BaQs/dragon-radar/hardware/dragon-radar-1.43/dragon-radar-1.43.3mf

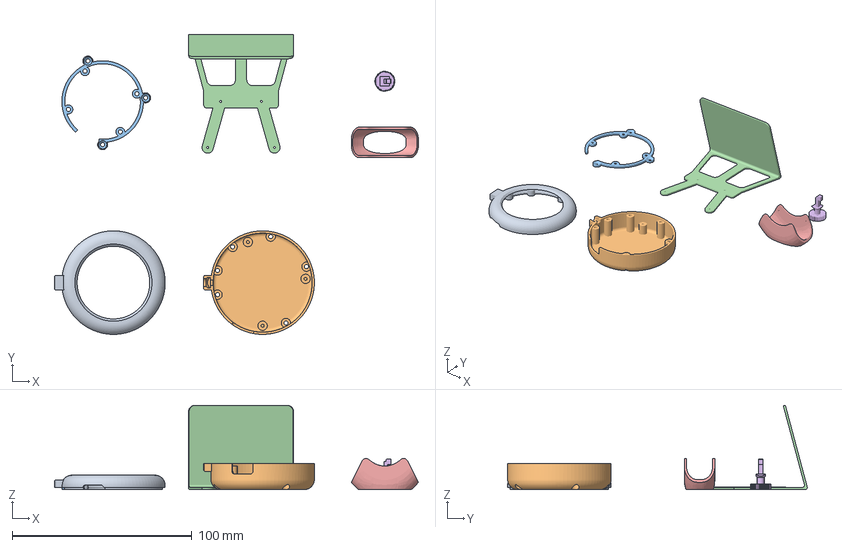
[picture p3: CAD file, 2026-11-02]
hardware/dragon-radar-1.43/dragon-radar-1.43.3mf
202.5 x 166.8 x 46.9 mm
Face (lèvre en haut)
Dos
Berceau de la carte
Support - pied
Support - berceau
Molette (roue en bas)
