BaQs/dragon-radar/hardware/dragon-radar-1.43/step/dos.step

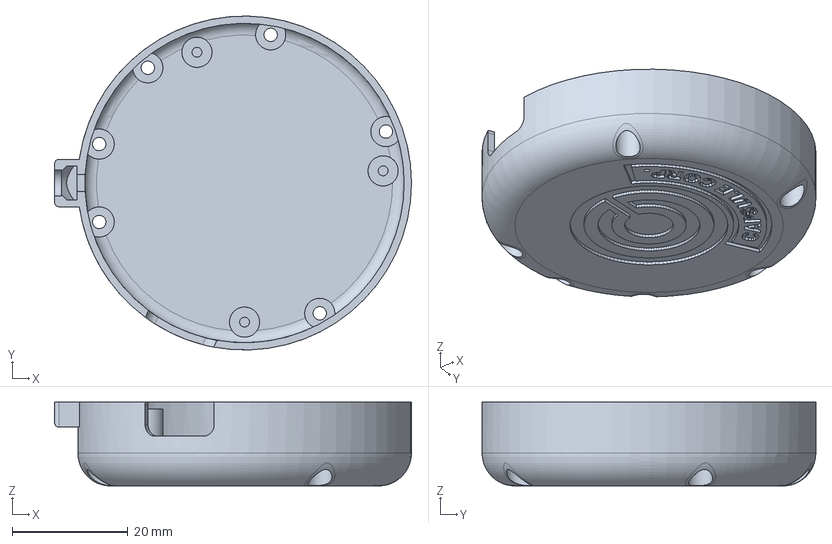
[picture p4: CAD file, 2026-11-02]
hardware/dragon-radar-1.43/step/dos.step
61.6 x 57.6 x 14.5 mm
