BaQs/dragon-radar/hardware/dragon-radar-1.43/step/support_pied.step

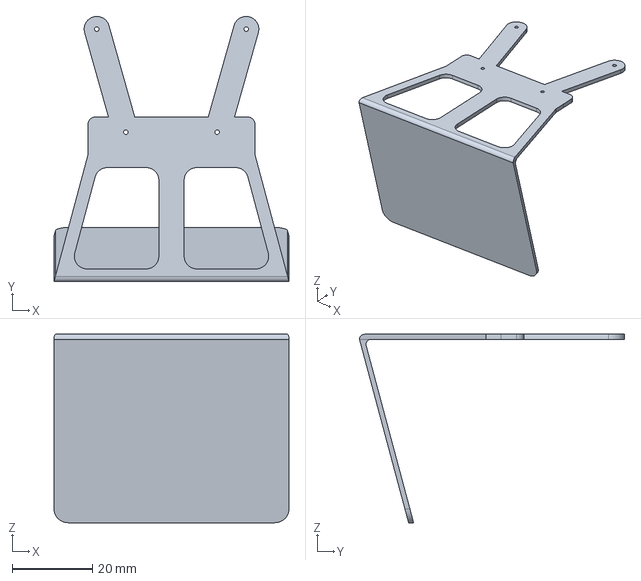
[picture p5: CAD file, 2026-11-02]
hardware/dragon-radar-1.43/step/support_pied.step
58.5 x 66.0 x 46.9 mm
