BaQs/dragon-radar/hardware/dragon-radar-1.43/step/support_berceau.step

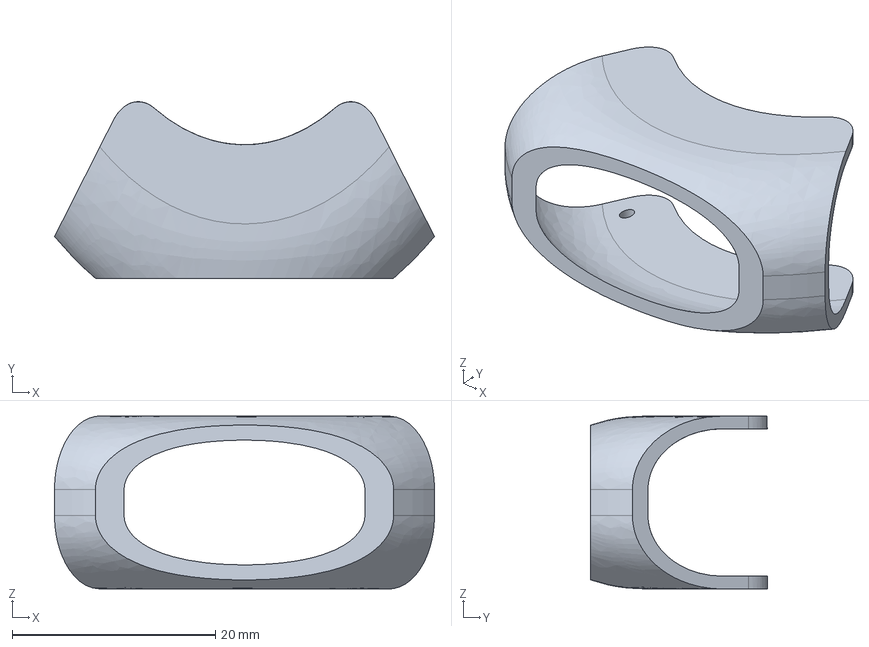
[picture p6: CAD file, 2026-11-02]
hardware/dragon-radar-1.43/step/support_berceau.step
37.4 x 17.4 x 17.0 mm
