BaQs/dragon-radar/hardware/dragon-radar-1.43/step/molette.step

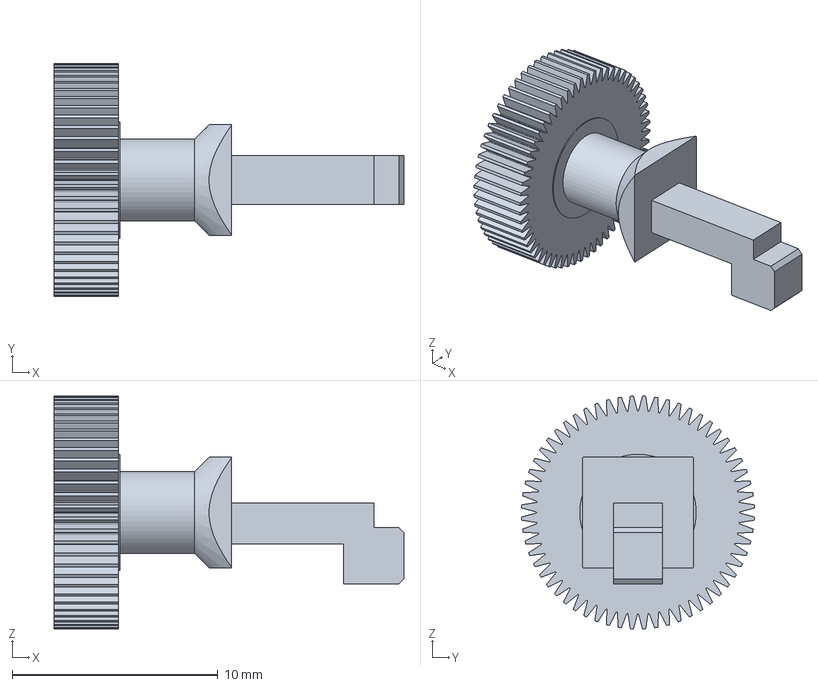
[picture p7: CAD file, 2026-11-02]
hardware/dragon-radar-1.43/step/molette.step
17.0 x 11.3 x 11.3 mm
