BaQs/dragon-radar/hardware/dragon-radar-1.43/step/face.step

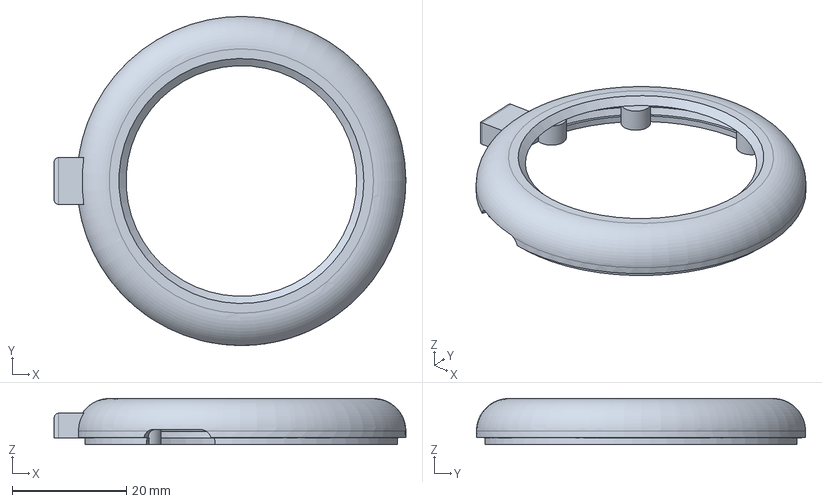
[picture p8: CAD file, 2026-11-02]
hardware/dragon-radar-1.43/step/face.step
61.6 x 57.6 x 8.06 mm
