BaQs/dragon-radar/hardware/dragon-radar-1.43/step/berceau.step

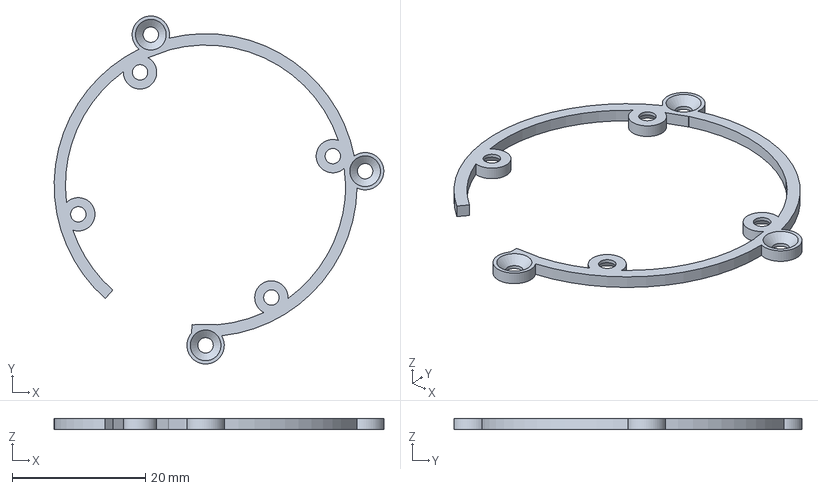
[picture p9: CAD file, 2026-11-02]
hardware/dragon-radar-1.43/step/berceau.step
49.4 x 52.1 x 1.60 mm
