BaQs/dragon-radar/hardware/dragon-radar-1.43/step/logo.step

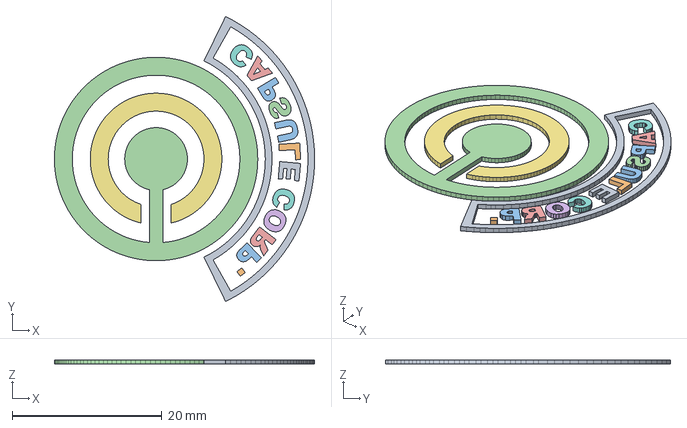
[picture p10: CAD file, 2026-11-02]
hardware/dragon-radar-1.43/step/logo.step
34.8 x 38.1 x 0.6 mm
