BaQs/dragon-radar/(list of files, cad)

Other CAD files:
hardware/dragon-radar-1.43/stl/berceau.stl
hardware/dragon-radar-1.43/stl/dos.stl
hardware/dragon-radar-1.43/stl/face.stl
hardware/dragon-radar-1.43/stl/logo.stl
hardware/dragon-radar-1.43/stl/molette.stl
hardware/dragon-radar-1.43/stl/support_berceau.stl
hardware/dragon-radar-1.43/stl/support_pied.stl
