BaQs/dragon-radar/src/main.cpp

// Capsule Radar — entry point / glue.
#include <Arduino.h>
#include <WiFi.h>
#include <vector>
#include "config.h"
#include "web_input.h"              // strict parsing of numbers from the config page
#include "aircraft.h"
#include "geo.h"
#include "adsb_client.h"
#include "snapshot_gate.h"
#include "feed_watchdog.h"
#include "route.h"
#include "route_client.h"
#include "photo.h"
#include "photo_client.h"
#include "weather.h"
#include "weather_client.h"
#include "wx_radar.h"
#include "wx_radar_client.h"
#include "cloud_image.h"
#include "cloud_image_client.h"
#include "radar_view.h"
#include "ui.h"
#include "display.h"                  // M0: CO5300 + LVGL bring-up
#include "imu_qmi8658.h"             // face-down sleep: accelerometer reads
#include "facedown_sleep.h"          // face-down sleep: the decision
#include "boot_button.h"             // BOOT button: zoom / deep sleep
#include <esp_sleep.h>
#include <driver/rtc_io.h>
#include "gps.h"                     // LC76G GNSS (-G variant only)
#include "battery.h"                 // AXP2101 battery gauge
#include "rtc_pcf85063.h"            // PCF85063 RTC (offline clock + date)
#include "audio.h"                   // ES8311 alert pings
#include <set>                       // audio: track which contacts are in range
#include <string>
#include <WiFiManager.h>             // captive portal
#include <Preferences.h>            // NVS (persist theme/settings)
#include <time.h>                   // NTP/RTC clock + date
#include <esp_sntp.h>               // SNTP sync callback: a REAL NTP fix (not just a plausible epoch)
#include <WebServer.h>              // configuration web page
#include <ESPmDNS.h>                // http://capsuleradar.local
#include <ArduinoOTA.h>             // OTA firmware update over WiFi (PlatformIO/espota)
#include <Update.h>                 // browser OTA: self-flash an uploaded .bin
#include <esp_heap_caps.h>          // largest-free-block metric (heap health)
#include <esp_wifi.h>               // WiFi driver control (reset must survive the reboot)
#include <nvs.h>                    // erase the driver's "nvs.net80211" namespace (WiFi reset)
#include <mbedtls/platform.h>       // route mbedTLS allocations to PSRAM

// mbedTLS allocates from internal RAM by default (the prebuilt core has
// CONFIG_MBEDTLS_INTERNAL_MEM_ALLOC). Its ~16 KB record buffers, allocated and freed on
// every HTTPS fetch, fragment the internal heap until a handshake can't find a
// contiguous block (-32512) and the feed freezes. Put them in PSRAM instead, the same
// as ESP-IDF's CONFIG_MBEDTLS_EXTERNAL_MEM_ALLOC; fall back to internal RAM if needed.
static void *tls_calloc(size_t n, size_t size) {
    return heap_caps_calloc_prefer(n, size, 2, MALLOC_CAP_SPIRAM | MALLOC_CAP_8BIT,
                                   MALLOC_CAP_INTERNAL | MALLOC_CAP_8BIT);
}
static void tls_free(void *p) { heap_caps_free(p); }

// ---- shared state ----
static std::vector<Aircraft> g_aircraft;      // latest snapshot
static SemaphoreHandle_t     g_ac_mutex;      // guards g_aircraft
static volatile bool         g_acDirty = false; // set when a new snapshot is ready
static AdsbClient            g_adsb;
static RadarSettings         g_settings;
static WiFiManager           g_wm;
static int                   g_brightnessDay = BRIGHTNESS_DEFAULT;   // user brightness (web/NVS)
static int                   g_volume = 60;                          // alert volume 0..100 (web/NVS)
static bool                  g_muted  = false;                       // mute alert pings
static int                   g_alertMode = 2;                        // 0=off 1=emergencies 2=new+emergencies (web/NVS)
static float                 g_proximityKm = 0.0f;                   // proximity alert radius, km (0=off) (web/NVS)
static uint32_t              g_idleDimMs = IDLE_DIM_MS;              // dim after this idle time (0 = never)
static bool                  g_fdSleep = true;                       // face-down sleep (screen off) on/off (web/NVS)
static bool                  g_clockOn = true;                       // idle clock instead of the idle dim (web/NVS)
static bool                  g_showSweep = true;                     // rotating sweep line on/off (web/NVS)
static int                   g_units = 0;                            // 0=Aviation 1=Metric 2=Imperial (web/NVS)
static bool                  g_showAirports = true;                  // airport markers on/off (web/NVS)
static bool                  g_hideGround   = false;                 // skip on-ground aircraft in the feed (web/NVS)
static int                   g_minAltFt     = 0;                     // only show aircraft above this altitude, ft (0 = off) (web/NVS)
static int                   g_maxAltFt     = 0;                     // only show aircraft below this altitude, ft (0 = off) (web/NVS)
static int                   g_lastView     = 0;                     // last active view (0 radar/1 list/2 stats/3 weather) (NVS)
static bool                  g_bootedIntoPortal = false;             // saved WiFi absent at boot (e.g. car hotspot not up yet)
static bool                  g_milOnly      = false;                 // only show military-flagged aircraft (web/NVS)
static int                   g_rotation = 0;                         // clockwise display rotation, 0..359° (web/NVS)
static bool                  g_useGps = false;                       // auto-set home from the LC76G GPS (-G variant) (web/NVS)
static int                   g_trailLen = 2;                         // aircraft trails 0=off 1=short 2=med 3=long (web/NVS)
static int                   g_maxAc = 20;                           // max aircraft drawn on the scope (web/NVS)
static bool                  g_bigText = false;                      // accessibility: large fonts (web/NVS, applied at boot)
static volatile bool         g_onBattery = false;                    // discharging (set on core 1, read on core 0)
static volatile bool         g_rtcSyncPending = false;               // SNTP synced: RTC should be rewritten on core 1
static std::vector<Aircraft> g_snap;                                 // last snapshot (instant re-render on zoom)
static volatile bool         g_requery = false;                      // range changed -> adsb_task re-begins
static float                 g_requeryKm = 0.0f;
static volatile bool         g_feedOk = true;                        // ADS-B feed healthy? (HUD warning)
static volatile uint32_t     g_lastFeedOkMs = 0;                     // millis() of the last good poll (HUD staleness)
static volatile uint32_t     g_powerOffAtMs = 0;                     // !=0: AXP2101 power-off when millis() reaches it
static volatile uint32_t     g_rebootAtMs = 0;                       // !=0: reboot when millis() reaches it (clean start after WiFi config)
static bool                  g_pmicOk = false;                       // AXP2101 answered (powers the power-off paths)
static bool                  g_updateBlocked = false;                // /update: refused at START (cross-site), 403 sent on completion
static bool                  g_updateDone = false;                   // /update: Update.end() succeeded -> the completion handler may reboot
static String                g_tz = TZ_STR;                          // POSIX timezone (web-configurable, NVS); applied via configTzTime
static volatile bool         g_weatherDirty = false;
static volatile bool         g_wxRadarDirty = false;
static volatile bool         g_cloudImageDirty = false;

// Web-selectable time zones (label + POSIX TZ). The <option> value is the index; the save
// handler maps it back to the POSIX string stored in NVS and used by configTzTime at boot.
// (Index avoids putting POSIX strings with '<>' / ',' into HTML attributes.)
// offMin = standard (winter) UTC offset in minutes; dst = 1 if the zone observes DST.
// The web page uses these to auto-pick the visitor's zone from their browser clock.
static const struct { const char *label; const char *tz; int offMin; int dst; } TZOPTS[] = {
    {"UTC",                      "UTC0",                              0, 0},
    {"London / Lisbon",          "GMT0BST,M3.5.0/1,M10.5.0",          0, 1},
    {"Madrid / Paris / Berlin",  "CET-1CEST,M3.5.0,M10.5.0/3",       60, 1},
    {"Athens / Helsinki",        "EET-2EEST,M3.5.0/3,M10.5.0/4",     120, 1},
    {"Istanbul / Moscow",        "<+03>-3",                          180, 0},
    {"New York (US Eastern)",    "EST5EDT,M3.2.0,M11.1.0",          -300, 1},
    {"Chicago (US Central)",     "CST6CDT,M3.2.0,M11.1.0",          -360, 1},
    {"Denver (US Mountain)",     "MST7MDT,M3.2.0,M11.1.0",          -420, 1},
    {"Phoenix (Arizona)",        "MST7",                            -420, 0},
    {"Los Angeles (US Pacific)", "PST8PDT,M3.2.0,M11.1.0",          -480, 1},
    {"Anchorage (Alaska)",       "AKST9AKDT,M3.2.0,M11.1.0",        -540, 1},
    {"Honolulu (Hawaii)",        "HST10",                           -600, 0},
    {"Argentina / Brazil (E)",   "<-03>3",                          -180, 0},
    {"India (IST)",              "<+0530>-5:30",                     330, 0},
    {"China / Singapore",        "<+08>-8",                          480, 0},
    {"Japan / Korea",            "JST-9",                            540, 0},
    {"Sydney (AU Eastern)",      "AEST-10AEDT,M10.1.0,M4.1.0/3",     600, 1},
    {"Auckland (NZ)",            "NZST-12NZDT,M9.5.0,M4.1.0/3",      720, 1},
};
static const int TZOPTS_N = sizeof(TZOPTS) / sizeof(TZOPTS[0]);

// ---- networking task (core 0): fetch + parse, never touches the display ----
static void adsb_task(void*) {
    std::vector<Aircraft> fresh;
    AircraftSnapshotGate snapshotGate;
    bool retainingEmptySnapshot = false;
    bool wasConnected = false;
    uint32_t lastPoll = 0;
    uint32_t nextWeatherAt = UINT32_MAX;       // armed five seconds after WiFi connects
    uint32_t nextWxRadarAt = UINT32_MAX;
    uint32_t nextCloudImageAt = UINT32_MAX;
    FeedWatchdog watchdog(millis());         // self-heal: see feed_watchdog.h
    for (;;) {
        const bool conn = (WiFi.status() == WL_CONNECTED);
        if (conn && !wasConnected) {
            // disable WiFi modem power-save: on a mains-powered desk gadget it just adds latency
            // and makes RSSI bounce (feed goes stale -> amber bars) even sitting next to the router.
            WiFi.setSleep(false);
            Serial.printf("[adsb] WiFi up, IP %s\n", WiFi.localIP().toString().c_str());
            configTzTime(g_tz.c_str(), "pool.ntp.org", "time.nist.gov");  // local time (web-configurable TZ)
            Serial.println("[web] config: http://capsuleradar.local/  (or the IP above)");
            nextWeatherAt = millis() + 5000UL; // let the first ADS-B poll complete before weather TLS
            nextCloudImageAt = millis() + 15000UL;
            nextWxRadarAt = millis() + 12000UL;
            // mDNS + OTA are started on core 1 (loop) to keep all mDNS use on one core
        }
        wasConnected = conn;
        // Self-heal: reboot at once for a fragmented internal heap starving TLS, and as a
        // last resort after ADSB_STUCK_HARD_MS whatever the heap says. Not for refusals or
        // a short internet outage behind working WiFi (see feed_watchdog.h).
        if (const uint32_t answeredMs = g_adsb.lastResponseMs()) watchdog.onAnswer(answeredMs);
        switch (watchdog.check(conn, millis(), g_adsb.allParked(), [] {
                    return (uint32_t)heap_caps_get_largest_free_block(MALLOC_CAP_INTERNAL); })) {
            case FeedWatchdog::RESTART:
                Serial.printf("[adsb] feed stuck >%us and internal heap fragmented -> restarting to recover\n",
                              (unsigned)(ADSB_STUCK_MS / 1000));
                delay(100);
                ESP.restart();
                break;
            case FeedWatchdog::RESTART_LONG:
                Serial.printf("[adsb] feed stuck >%u min with WiFi up -> restarting as a last resort\n",
                              (unsigned)(ADSB_STUCK_HARD_MS / 60000UL));
                delay(100);
                ESP.restart();
                break;
            case FeedWatchdog::LOG_STUCK:
                Serial.printf("[adsb] feed stuck >%us with WiFi up (no internet?); heap OK, staying up\n",
                              (unsigned)(ADSB_STUCK_MS / 1000));
                break;
            case FeedWatchdog::NONE:
                break;
        }
        if (g_requery) {                          // display range changed (double-tap zoom)
            g_adsb.begin(g_settings.homeLat, g_settings.homeLon, g_requeryKm);
            g_requery = false;
            lastPoll = 0;                         // poll immediately at the new radius
        }
        if (conn) {
            // The live aircraft feed is the primary job, so poll FIRST every cycle. That keeps
            // it refreshing even while the user taps around — a slow route/photo lookup (below)
            // can block this single network task, so it must never get ahead of the feed.
            const uint32_t nowMs = millis();
            const uint32_t pollInterval = g_onBattery ? POLL_INTERVAL_BATTERY_MS : POLL_INTERVAL_MS;
            if (lastPoll == 0 || nowMs - lastPoll >= pollInterval) {  // aircraft feed
                lastPoll = nowMs;
                static int failCount = 0;
                // poll() tries the fallback provider after a primary failure; keep the HUD
                // healthy through isolated misses and warn only after a sustained outage.
                if (g_adsb.poll(fresh)) {
                    Serial.printf("[adsb] fetched %u aircraft from %s\n", (unsigned)fresh.size(), g_adsb.lastHost());
                    failCount = 0;
                    g_feedOk = true;
                    const uint32_t receivedMs = millis();
                    watchdog.onPoll(FeedWatchdog::FETCHED, receivedMs);
                    g_lastFeedOkMs = receivedMs;      // HUD: mark data as fresh

                    const bool publish = snapshotGate.shouldPublish(
                        !fresh.empty(), receivedMs, AC_STALE_MS);
                    if (!publish) {
                        if (!retainingEmptySnapshot) {
                            Serial.printf("[adsb] empty snapshot; retaining contacts for %u ms\n",
                                          (unsigned)AC_STALE_MS);
                            retainingEmptySnapshot = true;
                        }
                    } else {
                        if (retainingEmptySnapshot && fresh.empty())
                            Serial.println("[adsb] empty snapshot persisted; clearing stale contacts");
                        retainingEmptySnapshot = false;
                        if (xSemaphoreTake(g_ac_mutex, pdMS_TO_TICKS(200)) == pdTRUE) {
                            g_aircraft.swap(fresh);   // O(1) handoff: no per-Aircraft String copies under the lock
                            g_acDirty = true;
                            xSemaphoreGive(g_ac_mutex);
                        }
                    }
                } else if (g_adsb.lastPollSkipped()) {
                    // Every provider is parked or inside its spacing/silence window: we chose
                    // not to ask. Logging this each tick would bury the real errors, and
                    // counting it would show an outage warning for our own politeness.
                    // Prolonged silence still trips the warning, via the time check rather
                    // than a fail count. Not proof of life for the watchdog: nothing was sent.
                    watchdog.onPoll(FeedWatchdog::SKIPPED, nowMs);
                    if ((int32_t)(nowMs - g_adsb.lastOkMs()) > (int32_t)ADSB_FEED_STALE_MS)
                        g_feedOk = false;
                } else {
                    Serial.println("[adsb] poll failed");
                    watchdog.onPoll(FeedWatchdog::FAILED, nowMs);
                    if (++failCount >= 5) g_feedOk = false;   // sustained outage -> HUD warning
                }
            }
            // Forecasts change slowly. Fetch only after the live ADS-B poll has had priority.
            if ((int32_t)(nowMs - nextWeatherAt) >= 0) {
                Serial.printf("[weather] fetching %.5f, %.5f...\n",
                              g_settings.homeLat, g_settings.homeLon);
                WeatherSnapshot forecast;
                if (weather_fetch(g_settings.homeLat, g_settings.homeLon, forecast)) {
                    weather_store(forecast);
                    g_weatherDirty = true;
                    nextWeatherAt = millis() + WEATHER_REFRESH_MS;
                    Serial.println("[weather] forecast updated");
                } else {
                    nextWeatherAt = millis() + 60000UL;
                    Serial.println("[weather] fetch failed; retrying in 60s");
                }
            }
            if ((int32_t)(nowMs - nextWxRadarAt) >= 0) {
                Serial.println("[wxradar] fetching latest frame...");
                if (wx_radar_fetch(g_settings.homeLat, g_settings.homeLon)) {
                    g_wxRadarDirty = true;
                    nextWxRadarAt = millis() + WX_RADAR_REFRESH_MS;
                } else {
                    nextWxRadarAt = millis() + 60000UL;
                    Serial.println("[wxradar] fetch failed; retrying in 60s");
                }
            }
            if ((int32_t)(nowMs - nextCloudImageAt) >= 0) {
                Serial.println("[clouds] fetching EUMETSAT frame...");
                if (cloud_image_fetch(g_settings.homeLat, g_settings.homeLon)) {
                    g_cloudImageDirty = true;
                    nextCloudImageAt = millis() + CLOUD_IMAGE_REFRESH_MS;
                } else {
                    nextCloudImageAt = millis() + 60000UL;
                    Serial.println("[clouds] fetch failed; retrying in 60s");
                }
            }
            // Then the on-demand lookups for the selected aircraft. Their timeouts are kept
            // short (see photo_client / route_client) so a slow photo server can't freeze the
            // feed for long; the next loop iteration polls again as soon as they return.
            char wantCall[12];
            if (route_pending(wantCall, sizeof(wantCall))) {
                char from[40] = "", to[40] = "";
                if (route_cache_get(wantCall, from, sizeof(from), to, sizeof(to))) {
                    route_store(wantCall, from, to);                       // NVS hit, no network
                    Serial.printf("[route] %s (cache): '%s' -> '%s'\n", wantCall, from, to);
                } else if (route_fetch(wantCall, from, sizeof(from), to, sizeof(to))) {
                    route_store(wantCall, from, to);
                    route_cache_put(wantCall, from, to);                  // remember across reboots
                    Serial.printf("[route] %s (net): '%s' -> '%s'\n", wantCall, from, to);
                } else {
                    route_store(wantCall, from, to);   // empty -> don't refetch this session
                    Serial.printf("[route] %s: no route\n", wantCall);
                }
            }
            char wantHex[10];
            if (photo_pending(wantHex, sizeof(wantHex))) photo_fetch(wantHex);
        }
        vTaskDelay(pdMS_TO_TICKS(250));
    }
}

static void loadSettings() {
    Preferences p;
    p.begin("capsuleradar", true);
    g_settings.homeLat = p.getDouble("homeLat", HOME_LAT_DEFAULT);
    g_settings.homeLon = p.getDouble("homeLon", HOME_LON_DEFAULT);
    // Repair a value that can't work: an old install may hold the 250 km the web page once
    // offered (clamped to 150) or even 0 (divides by zero in geo::projectToScreen).
    g_settings.rangeKm = repairRangeKm(p.getFloat("rangeKm", RANGE_KM_DEFAULT));
    // floor of 5: a stored 0 would boot with the panel dark forever, looking like a dead board
    g_brightnessDay    = constrain(p.getInt("bright", BRIGHTNESS_DEFAULT), 5, 255);
    g_volume           = p.getInt("vol", 60);
    g_muted            = p.getBool("mute", false);
    g_alertMode        = p.getInt("alertmode", 2);
    g_proximityKm      = p.getFloat("proxkm", 0.0f);
    g_useGps           = p.getBool("usegps", false);
    g_trailLen         = p.getInt("traillen", 2);
    g_maxAc            = p.getInt("maxac", 20);
    g_idleDimMs        = p.getUInt("idledim", IDLE_DIM_MS);
    g_fdSleep          = p.getBool("fdsleep", true);
    g_clockOn          = p.getBool("clock", true);
    g_units            = p.getInt("units", 0);
    g_tz               = p.getString("tz", TZ_STR);
    g_bigText          = p.getBool("bigtext", false);
    p.end();
    // fonts are baked into the widgets at creation time, so the large-text flag must be
    // in place before display::begin() builds the UI (loadSettings runs first in setup)
    ui_set_large_text(g_bigText);
    radar::setLargeText(g_bigText);
}

// Audio alerts. g_alertMode: 0 = off, 1 = emergencies only, 2 = new aircraft + emergencies.
// g_proximityKm > 0 also pings (once) when any aircraft crosses into that radius.
static void checkAudioEvents() {
    if (!audio_present()) return;
    static std::set<std::string> seen, seenProx;
    static bool first = true;
    static uint32_t lastNew = 0;
    std::set<std::string> now, nowProx;
    for (const Aircraft &ac : g_snap) {
        const double d = geo::haversineKm(g_settings.homeLat, g_settings.homeLon, ac.lat, ac.lon);
        if (d > g_settings.rangeKm) continue;                 // in-range only
        const std::string hex = ac.hex.c_str();
        now.insert(hex);
        const bool isNew     = !first && !seen.count(hex);
        const bool emergency = acIsEmergency(ac.squawk) || ac.military;  // military: feed dbFlags

        // proximity: fire once, when an aircraft first crosses into the radius (any aircraft)
        if (g_proximityKm > 0.0f && d <= g_proximityKm) {
            nowProx.insert(hex);
            if (!first && !seenProx.count(hex)) audio_play(AUDIO_ALERT);
        }

        // new-in-range pings (on entry), gated by the alert mode
        if (isNew) {
            if (emergency) { if (g_alertMode >= 1) audio_play(AUDIO_ALERT); }   // emergencies only / +new
            else if (g_alertMode >= 2 && millis() - lastNew > 3000) {
                audio_play(AUDIO_NEW);                                          // new contact (rate-limited)
                lastNew = millis();
            }
        }
    }
    seen.swap(now);
    seenProx.swap(nowProx);
    first = false;
}

// Feed query radius: wider than the display range (so off-range traffic shows as edge
// arrows) AND wide enough to cover the proximity-alert circle (else an alert radius larger
// than the query would never fire), clamped to keep busy-airspace downloads bounded.
static float queryRadiusKm() {
    float km = g_settings.rangeKm * ADSB_QUERY_MULT;
    if (g_proximityKm > 0.0f && g_proximityKm * 1.2f > km) km = g_proximityKm * 1.2f;
    return constrain(km, ADSB_QUERY_MIN_KM, ADSB_QUERY_MAX_KM);
}

// Double-tap zoom: change the display range, persist it, and ask adsb_task to
// re-query at a matching radius (safely, on its own core). Re-render immediately.
static void onRangeChange(float km) {
    g_settings.rangeKm = km;
    Preferences p;
    p.begin("capsuleradar", false);
    p.putFloat("rangeKm", km);
    p.end();
    g_requeryKm = queryRadiusKm();
    g_requery = true;
    radar::update(g_snap, g_settings);   // instant visual zoom from the last snapshot
    ui_set_range_km(km);
    ui_on_data_updated();
}

// Persist the visual theme in NVS (called when the user long-presses to switch).
static void saveTheme(int t) {
    Preferences p;
    p.begin("capsuleradar", false);
    p.putInt("theme", t);
    p.end();
}

// Convert a UTC broken-down time to time_t (mktime assumes local TZ, so flip to UTC0).
static time_t utc_to_time(struct tm *utc) {
    setenv("TZ", "UTC0", 1); tzset();
    const time_t t = mktime(utc);
    setenv("TZ", g_tz.c_str(), 1); tzset();   // restore the SAVED zone, not the Spain default
    return t;
}

// Seed the ESP system clock from the RTC so the clock/date are right before NTP.
static void rtc_seed_clock() {
    struct tm utc;
    if (!rtc_read(&utc)) { Serial.println("[rtc] no valid time stored"); return; }
    const time_t t = utc_to_time(&utc);
    struct timeval tv = { t, 0 };
    settimeofday(&tv, nullptr);
    Serial.println("[rtc] system clock seeded from RTC");
}

// Brightness: face-down sleep wins (screen off), then the idle clock, then the idle dim.
// The clock ramps the panel from the day brightness to clockB along with its animation,
// so the loop calls this on every pass; the panel is written only when the value changes.
static bool g_asleep    = false;   // face-down
static bool g_idle      = false;   // no touch for a while
static bool g_clockHold = false;   // idle with the clock on, but an emergency in range keeps the radar up
static void applyBrightness() {
    const int day = g_brightnessDay;
    int b = day;
    // p is 0 on the pass that starts the clock (and a full LVGL repaint follows it), so test
    // clockRequested() too: falling through to the idle dim there would blink the panel.
    const float p = radar::clockProgress();
    if (radar::clockRequested() || p > 0) {
        const int clockB = max(day * CLOCK_BRIGHTNESS_PCT / 100, min(day, BRIGHTNESS_IDLE));
        b = day + (int)lroundf((float)(clockB - day) * p);
    } else if (g_idle && !g_clockHold) {
        b = min(day, BRIGHTNESS_IDLE);                           // idle only dims down
    }
    if (g_asleep) b = 0;                                         // face-down -> screen off
    static int shown = -1;
    if (b != shown) { shown = b; display::setBrightness((uint8_t)b); }
}

// ----------------------------- configuration web --------------------------------
static WebServer g_web(80);

// ---- cross-site request guard (CSRF) ----
// A hostile web page can make the VICTIM's browser send requests to this device, which
// sits on the same LAN. It cannot read any answer (we send no CORS headers), so refusing
// the request defeats it. Two layers:
//  - requestCrossSite() refuses what the browser itself marks as cross-site. Over plain
//    http:// browsers send NO Sec-Fetch-Site (Fetch Metadata only goes to HTTPS and
//    localhost), but every cross-site POST carries Origin. That guards the POSTs (/save,
//    /wifi, /poweroff, /update): plain HTML forms send those, so they cannot carry a
//    custom header. Same-origin requests and header-less clients (curl, the IDE's
//    uploader) pass.
//  - refuseUnlessPageFetch() guards the live-setting GETs (/bright, /vol, ...) as well. A
//    cross-site <img src="http://capsuleradar.local/bright?v=5"> sends neither
//    Sec-Fetch-Site nor Origin, so these also demand the WEB_PAGE_HDR header. Only a script
//    can add a custom header, and a cross-origin fetch() with one needs a CORS preflight
//    this server never approves; <img>, links and forms cannot send it at all. The config
//    page's own fetch() calls (G() in its script) send it; curl needs -H 'X-Radar: 1'.
#define WEB_PAGE_HDR "X-Radar"
static bool requestCrossSite() {
    const String sfs = g_web.header("Sec-Fetch-Site");
    if (sfs.length() && sfs != "same-origin" && sfs != "none") return true;
    const String origin = g_web.header("Origin");
    if (origin.length()) {
        // "http://192.168.4.1" / "https://capsuleradar.local": compare the authority
        // with the Host header, ignoring default ports on either side.
        const int scheme = origin.indexOf("://");
        String auth = (scheme < 0) ? origin : origin.substring(scheme + 3);
        const int slash = auth.indexOf('/');
        if (slash >= 0) auth = auth.substring(0, slash);
        String host = g_web.hostHeader();
        if (auth.endsWith(":80"))  auth = auth.substring(0, auth.length() - 3);
        if (auth.endsWith(":443")) auth = auth.substring(0, auth.length() - 4);
        if (host.endsWith(":80"))  host = host.substring(0, host.length() - 3);
        if (host.endsWith(":443")) host = host.substring(0, host.length() - 4);
        if (!auth.equalsIgnoreCase(host)) return true;
    }
    return false;
}

// First line of every state-changing POST handler: rejects (and answers 403) or passes.
static bool refuseIfCrossSite() {
    if (!requestCrossSite()) return false;
    g_web.send(403, "text/plain", "cross-site request rejected");
    return true;
}

// First line of every live-setting GET handler (see the guard notes above).
static bool refuseUnlessPageFetch() {
    if (g_web.header(WEB_PAGE_HDR) != "1") {
        g_web.send(403, "text/plain", "missing " WEB_PAGE_HDR " header");
        return true;
    }
    return refuseIfCrossSite();
}

static void handleRoot() {
    const int th = radar::theme();
    // The page's own list (WEB_RANGE_KM, config.h) ends at 150 km: it once offered 250,
    // which the feed query clamps to ADSB_QUERY_MAX_KM — the outer rings stayed empty.
    // The value submitted stays in km (the device works in km); only the label is shown in
    // the user's chosen distance unit so the config page matches the screen. A stored
    // range that isn't in the list (20 km from the zoom button) gets its own entry with its
    // exact value, so saving the form with the other fields leaves the range alone.
    const float    ufac  = (g_units == 0) ? 0.539957f : (g_units == 2 ? 0.621371f : 1.0f);
    const char    *uname = (g_units == 0) ? "nm" : (g_units == 2 ? "mi" : "km");
    String ropts;
    bool   rlisted = false;
    for (float rkm : WEB_RANGE_KM) {
        const bool sel = fabsf(rkm - g_settings.rangeKm) < 0.05f;
        if (sel) rlisted = true;
        char o[72];
        snprintf(o, sizeof(o), "<option value=%d%s>%.0f %s</option>",
                 (int)(rkm + 0.5f), sel ? " selected" : "", rkm * ufac, uname);
        ropts += o;
    }
    if (!rlisted) {
        char o[80];
        snprintf(o, sizeof(o), "<option value=%.2f selected>%.0f %s</option>",
                 g_settings.rangeKm, g_settings.rangeKm * ufac, uname);
        ropts += o;
    }
    const char *tnames[] = {"Phosphor", "Orb", "Amber CRT", "Military"};
    String topts;
    for (int i = 0; i < 4; ++i) {
        char o[80];
        snprintf(o, sizeof(o), "<option value=%d%s>%s</option>", i, i == th ? " selected" : "", tnames[i]);
        topts += o;
    }
    const int idleSecs[] = {10, 20, 30, 60, 120, 300, 1800, 3600, 7200, 14400, 28800};
    const int curIdle = (int)(g_idleDimMs / 1000);
    String iopts;
    for (int sV : idleSecs) {
        char lbl[16];
        if      (sV < 60)   snprintf(lbl, sizeof(lbl), "%d s", sV);
        else if (sV < 3600) snprintf(lbl, sizeof(lbl), "%d min", sV / 60);
        else                snprintf(lbl, sizeof(lbl), "%d h", sV / 3600);
        char o[96];
        snprintf(o, sizeof(o), "<option value=%d%s>%s</option>", sV, sV == curIdle ? " selected" : "", lbl);
        iopts += o;
    }
    { char o[64]; snprintf(o, sizeof(o), "<option value=0%s>Never</option>", curIdle == 0 ? " selected" : ""); iopts += o; }
    const char *unames[] = {"Aviation (ft, kt, nm)", "Metric (m, km/h, km)", "Imperial (ft, mph, mi)"};
    String uopts;
    for (int i = 0; i < 3; ++i) {
        char o[96];
        snprintf(o, sizeof(o), "<option value=%d%s>%s</option>", i, i == g_units ? " selected" : "", unames[i]);
        uopts += o;
    }
    const char *tlnames[] = {"Off", "Short", "Medium", "Long"};
    String tlopts;
    for (int i = 0; i < 4; ++i) {
        char o[64];
        snprintf(o, sizeof(o), "<option value=%d%s>%s</option>", i, i == g_trailLen ? " selected" : "", tlnames[i]);
        tlopts += o;
    }
    const int mxvals[] = {10, 15, 20, 30, 40, 60};   // max aircraft on the scope (<= feed cap)
    String mxopts;
    for (int mv : mxvals) {
        char o[64];
        snprintf(o, sizeof(o), "<option value=%d%s>%d</option>", mv, mv == g_maxAc ? " selected" : "", mv);
        mxopts += o;
    }
    // minimum-altitude filter options (stored in ft; labels show ft + km for clarity)
    const struct { int ft; const char *lbl; } mavals[] = {
        {0, "Off"}, {5000, "&gt; 5,000 ft (1.5 km)"}, {10000, "&gt; 10,000 ft (3 km)"},
        {20000, "&gt; 20,000 ft (6 km)"}, {33000, "&gt; 33,000 ft (10 km)"},
    };
    String maopts;
    for (auto &mv : mavals) {
        char o[96];
        snprintf(o, sizeof(o), "<option value=%d%s>%s</option>", mv.ft, mv.ft == g_minAltFt ? " selected" : "", mv.lbl);
        maopts += o;
    }
    // maximum-altitude filter (heli / low-traffic spotting): same steps, "below" phrasing
    const struct { int ft; const char *lbl; } mbvals[] = {
        {0, "Off"}, {5000, "&lt; 5,000 ft (1.5 km)"}, {10000, "&lt; 10,000 ft (3 km)"},
        {20000, "&lt; 20,000 ft (6 km)"},
    };
    String mbopts;
    for (auto &mv : mbvals) {
        char o[96];
        snprintf(o, sizeof(o), "<option value=%d%s>%s</option>", mv.ft, mv.ft == g_maxAltFt ? " selected" : "", mv.lbl);
        mbopts += o;
    }
    const char *anames[] = {"Off", "Emergencies only", "New aircraft + emergencies"};
    String aopts;
    for (int i = 0; i < 3; ++i) {
        char o[80];
        snprintf(o, sizeof(o), "<option value=%d%s>%s</option>", i, i == g_alertMode ? " selected" : "", anames[i]);
        aopts += o;
    }
    const int proxUnit[] = {0, 2, 5, 10, 25};   // 0 = off; rest in the user's distance unit
    String popts;
    for (int pv : proxUnit) {
        const float pkm = (pv == 0) ? 0.0f : (pv / ufac);   // user unit -> km (value submitted)
        const bool  sel = (pv == 0) ? (g_proximityKm <= 0.0f) : (fabsf(g_proximityKm - pkm) < 0.4f);
        char lbl[24];
        if (pv == 0) snprintf(lbl, sizeof(lbl), "Off");
        else         snprintf(lbl, sizeof(lbl), "%d %s", pv, uname);
        char o[80];
        snprintf(o, sizeof(o), "<option value=%.3f%s>%s</option>", pkm, sel ? " selected" : "", lbl);
        popts += o;
    }
    String tzopts;   // time-zone dropdown (value = index into TZOPTS; mapped to POSIX TZ on save)
    for (int i = 0; i < TZOPTS_N; ++i) {
        char o[128];
        snprintf(o, sizeof(o), "<option value=%d data-off=%d data-dst=%d%s>%s</option>",
                 i, TZOPTS[i].offMin, TZOPTS[i].dst, g_tz == TZOPTS[i].tz ? " selected" : "", TZOPTS[i].label);
        tzopts += o;
    }
    String gpsRow;   // only on the -G variant: offer to auto-set the centre from GPS
    if (gps_present()) {
        gpsRow  = "<label><input type=checkbox class=ck ";
        gpsRow += g_useGps ? "checked" : "";
        gpsRow += " onchange='gp(this.checked)'>Use GPS for location</label>";
        gpsRow += "<div style='font-size:12px;opacity:.6;margin:-2px 0 6px'>"
                  "When on, the location above is used until the GPS gets a fix, then it takes over.</div>";
    }
    // 16 KB: the page outgrew 10 KB (~10.3 KB with the GPS row), and snprintf silently cut
    // off the closing </script>, so none of the live-setting handlers existed in the browser.
    static const size_t BUFSZ = 16384;
    static char *buf = (char *)ps_malloc(BUFSZ);   // PSRAM: keep this big page buffer off the scarce
    if (!buf) return;                              //   internal heap (the contiguous RAM mbedTLS needs)
    const int len = snprintf(buf, BUFSZ,
        "<!DOCTYPE html><html><head><meta charset=utf-8>"
        "<meta name=viewport content='width=device-width,initial-scale=1'>"
        "<title>Capsule Radar</title>"
        "<link rel=stylesheet href='https://unpkg.com/leaflet@1.9.4/dist/leaflet.css'>"
        "<script src='https://unpkg.com/leaflet@1.9.4/dist/leaflet.js'></script>"
        "<style>"
        "*{box-sizing:border-box}"
        "body{background:radial-gradient(circle at 50%% -10%%,#0a1f15,#04100a 70%%);color:#cdd6d1;"
        "font-family:system-ui,-apple-system,sans-serif;margin:0 auto;padding:20px;max-width:480px;min-height:100vh}"
        ".hd{display:flex;align-items:center;gap:12px;margin-bottom:16px}"
        ".dot{width:44px;height:44px;border-radius:50%%;border:2px solid #1dff86;position:relative;"
        "overflow:hidden;flex:0 0 auto;box-shadow:0 0 16px rgba(29,255,134,.4)}"
        ".dot::before{content:'';position:absolute;inset:0;animation:sw 3s linear infinite;"
        "background:conic-gradient(from 0deg,rgba(29,255,134,.65),transparent 55%%)}"
        "@keyframes sw{to{transform:rotate(360deg)}}"
        "h1{color:#1dff86;font-size:20px;margin:0}.sub{color:#6f8c7d;font-size:12px;margin:2px 0 0}"
        ".t{color:#1dff86;font-size:11px;letter-spacing:1.5px;text-transform:uppercase;margin-bottom:10px;opacity:.85}"
        "label{display:block;margin:12px 0 4px;color:#9affc8;font-size:13px}"
        "input,select{width:100%%;box-sizing:border-box;padding:10px;border-radius:8px;border:1px solid #2a4a39;"
        "background:#0c1a12;color:#eafff3;font-size:16px}"
        "input:focus,select:focus{outline:none;border-color:#1dff86;box-shadow:0 0 0 2px rgba(29,255,134,.18)}"
        "button{margin-top:16px;width:100%%;padding:12px;border:0;border-radius:8px;background:#1dff86;"
        "color:#04140b;font-weight:700;font-size:16px}button:active{opacity:.85}"
        ".w{background:#ffb23c}.card{background:rgba(10,20,14,.85);border:1px solid #1f3a2b;border-radius:14px;padding:16px;margin-bottom:14px}"
        ".ft{color:#5f7a6c;font-size:12px;text-align:center;margin-top:6px}.ft code{color:#9affc8}"
        ".ck{width:auto;display:inline;margin-right:8px;vertical-align:middle}"
        ".sec{background:#0c1a12!important;color:#1dff86!important;border:1px solid #2a4a39!important}"
        "#map{height:220px;border-radius:10px;margin:6px 0 8px;border:1px solid #2a4a39;z-index:0}"
        "</style></head><body>"
        "<div class=hd><div class=dot></div><div><h1>Capsule Radar</h1><p class=sub>Live ADS-B radar &middot; configuration</p></div></div>"
        "<div class=card><div class=t>Location &amp; range</div><form method=POST action=/save>"
        "<label>Center point &mdash; tap the map or drag the pin</label>"
        "<div id=map></div>"
        "<label>Center latitude</label><input id=lat name=lat value='%.5f'>"
        "<label>Center longitude</label><input id=lon name=lon value='%.5f'>"
        "%s"
        "<label>Display range</label><select name=range>%s</select>"
        "<label>Theme</label><select name=theme>%s</select>"
        "<label>Time zone</label><select name=tz>%s</select>"
        "<button>Save &amp; restart</button></form></div>"
        "<div class=card><div class=t>Display</div>"
        "<label>Brightness</label>"
        "<input type=range min=5 max=255 value='%d' oninput='b(this.value,0)' onchange='b(this.value,1)'>"
        "<label>Clock or dim after</label><select onchange='d(this.value)'>%s</select>"
        "<label><input type=checkbox class=ck %s onchange='cl(this.checked)'>Show a clock instead of dimming</label>"
        "<label><input type=checkbox class=ck %s onchange='fd(this.checked)'>Screen off when placed face-down</label>"
        "<label><input type=checkbox class=ck %s onchange='sw(this.checked)'>Show radar sweep</label>"
        "<label><input type=checkbox class=ck %s onchange='ap(this.checked)'>Show airports</label>"
        "<label><input type=checkbox class=ck %s onchange='hg(this.checked)'>Hide aircraft on the ground</label>"
        "<label>Minimum altitude</label><select onchange='ma(this.value)'>%s</select>"
        "<label>Maximum altitude</label><select onchange='mb(this.value)'>%s</select>"
        "<label><input type=checkbox class=ck %s onchange='mo(this.checked)'>Military aircraft only</label>"
        "<label>Aircraft trails</label><select onchange='tl(this.value)'>%s</select>"
        "<label>Max aircraft on screen</label><select onchange='mx(this.value)'>%s</select>"
        "<label><input type=checkbox class=ck %s onchange='bt(this.checked)'>Large text (restarts the device)</label>"
        "<label>Screen rotation (degrees clockwise)</label>"
        "<input type=number min=0 max=359 step=1 value='%d' onchange='ro(this.value)'>"
        "<label>Units</label><select onchange='u(this.value)'>%s</select></div>"
        "<div class=card><div class=t>Sound</div>"
        "<label>Volume</label>"
        "<input type=range min=0 max=100 value='%d' oninput='v(this.value,0)' onchange='v(this.value,1)'>"
        "<label><input type=checkbox class=ck %s onchange='m(this.checked)'>Mute alerts</label>"
        "<label>Alert on</label><select onchange='al(this.value)'>%s</select>"
        "<label>Proximity alert</label><select onchange='px(this.value)'>%s</select>"
        "<button type=button class=sec onclick='t()'>Test ping</button></div>"
        "<div class=card><div class=t>Network</div>"
        "<p style='color:#9affc8;font-size:13px;margin:0 0 4px'>Forget the saved WiFi and reopen the setup portal.</p>"
        "<form method=POST action=/wifi><button class=w>Reset WiFi</button></form></div>"
        "<p class=ft>Reach me at <code>capsuleradar.local</code> &middot; <a href=/update style='color:#9affc8'>Firmware update</a> &middot; v" FW_VERSION "</p>"
        "<script>"
        "var C=[%.5f,%.5f];var MAP=L.map('map').setView(C,10);"
        "L.tileLayer('https://tile.openstreetmap.org/{z}/{x}/{y}.png',{maxZoom:19,attribution:'(c) OpenStreetMap'}).addTo(MAP);"
        "var MK=L.marker(C,{draggable:true}).addTo(MAP);"
        "function S(p){document.getElementById('lat').value=p.lat.toFixed(5);document.getElementById('lon').value=p.lng.toFixed(5);}"
        "MK.on('dragend',function(){S(MK.getLatLng());});"
        "MAP.on('click',function(e){MK.setLatLng(e.latlng);S(e.latlng);});"
        "setTimeout(function(){MAP.invalidateSize();},300);"
        "function G(p){fetch(p,{headers:{'" WEB_PAGE_HDR "':'1'}})}"
        "function b(v,s){G('/bright?v='+v+(s?'&save=1':''))}"
        "function v(x,s){G('/vol?v='+x+(s?'&save=1':''))}"
        "function m(c){G('/vol?mute='+(c?1:0)+'&save=1')}"
        "function t(){G('/vol?test=1')}"
        "function d(v){G('/idle?v='+v+'&save=1')}"
        "function fd(c){G('/fdsleep?v='+(c?1:0)+'&save=1')}"
        "function sw(c){G('/sweep?v='+(c?1:0)+'&save=1')}"
        "function ap(c){G('/airports?v='+(c?1:0)+'&save=1')}"
        "function hg(c){G('/ground?v='+(c?1:0)+'&save=1')}"
        "function ma(v){G('/altmin?v='+v+'&save=1')}"
        "function mb(v){G('/altmax?v='+v+'&save=1')}"
        "function mo(c){G('/milonly?v='+(c?1:0)+'&save=1')}"
        "function tl(v){G('/trail?v='+v+'&save=1')}"
        "function mx(v){G('/maxac?v='+v+'&save=1')}"
        "function bt(c){G('/bigtext?v='+(c?1:0)+'&save=1')}"
        "function ro(v){G('/rotate?v='+v+'&save=1')}"
        "function u(v){G('/units?v='+v+'&save=1')}"
        "function al(v){G('/alerts?mode='+v+'&save=1')}"
        "function px(v){G('/alerts?prox='+v+'&save=1')}"
        "function gp(c){G('/gps?v='+(c?1:0)+'&save=1')}"
        "function cl(c){G('/clock?v='+(c?1:0)+'&save=1')}"
        // auto-pick the visitor's time zone from their browser clock (only if they haven't set one)
        "var TZSET=%d;(function(){if(TZSET)return;"
        "var d=new Date(),j=new Date(d.getFullYear(),0,1).getTimezoneOffset(),"
        "u=new Date(d.getFullYear(),6,1).getTimezoneOffset(),o=-Math.max(j,u),s=(j!=u)?1:0,"
        "e=document.querySelector('select[name=tz]'),b=-1,i;"
        "for(i=0;i<e.options.length;i++){if(+e.options[i].dataset.off===o&&+e.options[i].dataset.dst===s){b=i;break;}}"
        "if(b<0)for(i=0;i<e.options.length;i++){if(+e.options[i].dataset.off===o){b=i;break;}}"
        "if(b>=0)e.selectedIndex=b;})();</script></body></html>",
        g_settings.homeLat, g_settings.homeLon, gpsRow.c_str(), ropts.c_str(), topts.c_str(),
        tzopts.c_str(),
        g_brightnessDay, iopts.c_str(), g_clockOn ? "checked" : "", g_fdSleep ? "checked" : "", g_showSweep ? "checked" : "",
        g_showAirports ? "checked" : "", g_hideGround ? "checked" : "", maopts.c_str(), mbopts.c_str(), g_milOnly ? "checked" : "",
        tlopts.c_str(), mxopts.c_str(), g_bigText ? "checked" : "", g_rotation, uopts.c_str(),
        g_volume, g_muted ? "checked" : "", aopts.c_str(), popts.c_str(),
        g_settings.homeLat, g_settings.homeLon, (g_tz == TZ_STR ? 0 : 1));
    if (len >= (int)BUFSZ)   // truncated page = broken <script>; make it loud, not silent
        Serial.printf("[web] config page truncated: %d bytes > %u buffer\n", len, (unsigned)BUFSZ);
    g_web.send(200, "text/html", buf);
}

// Nothing saved and no restart when an input is invalid: the browser shows this short
// error page instead of the device rebooting centred on (0,0).
static void sendSaveError(const char *field) {
    String body = "<body style='background:#06100a;color:#ffb23c;font-family:sans-serif;padding:24px'>"
                  "Not saved: <b>";
    body += field;
    body += "</b> must be a number like 38.8409 (dot or comma). "
            "<a href='/' style='color:#1dff86'>Back to settings</a></body>";
    g_web.send(400, "text/html", body);
}

static void handleSave() {
    if (refuseIfCrossSite()) return;
    // Validate EVERYTHING first, write only if all fields pass. String::toDouble() used
    // to accept "" (0) and "38,84" (38) — both inside the valid range, both saved.
    double lat = 0.0, lon = 0.0, range = 0.0;
    if (g_web.hasArg("lat")) {
        if (!parseDoubleStrict(g_web.arg("lat").c_str(), &lat)) return sendSaveError("latitude");
        if (lat < -90.0 || lat > 90.0)          return sendSaveError("latitude (must be -90..90)");
    }
    if (g_web.hasArg("lon")) {
        if (!parseDoubleStrict(g_web.arg("lon").c_str(), &lon)) return sendSaveError("longitude");
        if (lon < -180.0 || lon > 180.0)        return sendSaveError("longitude (must be -180..180)");
    }
    if (g_web.hasArg("range")) {
        if (!parseDoubleStrict(g_web.arg("range").c_str(), &range)) return sendSaveError("display range");
    }
    const int tzIdx = g_web.hasArg("tz") ? g_web.arg("tz").toInt() : -1;

    Preferences p;
    p.begin("capsuleradar", false);
    if (g_web.hasArg("lat"))   p.putDouble("homeLat", lat);
    if (g_web.hasArg("lon"))   p.putDouble("homeLon", lon);
    // range: repaired, not snapped — never 0 (divides by zero in geo::projectToScreen)
    if (g_web.hasArg("range")) p.putFloat("rangeKm", repairRangeKm((float)range));
    if (g_web.hasArg("theme")) p.putInt("theme", g_web.arg("theme").toInt());
    if (tzIdx >= 0 && tzIdx < TZOPTS_N) p.putString("tz", TZOPTS[tzIdx].tz);
    p.end();
    g_web.send(200, "text/html",
        "<meta http-equiv=refresh content='4;url=/'><body style='background:#06100a;color:#1dff86;"
        "font-family:sans-serif;padding:24px'>Saved. Restarting&hellip;</body>");
    delay(400);
    ESP.restart();
}

static void handleWifi() {
    if (refuseIfCrossSite()) return;
    g_web.send(200, "text/html",
        "<body style='background:#06100a;color:#ffb23c;font-family:sans-serif;padding:24px'>"
        "WiFi reset. Connect to the <b>CapsuleRadar-Setup</b> network to reconfigure.</body>");
    delay(400);                     // let the response reach the browser
    // The driver stores the saved AP in its own NVS namespace ("nvs.net80211"). On Arduino
    // core 3.x both wm.resetSettings() and WiFi.disconnect(true,true) can silently no-op
    // (they fail once the driver is off), so v1.3.19's reset still reconnected. Erasing that
    // namespace directly is unconditional — it works whatever state the WiFi driver is in.
    g_wm.resetSettings();           // best-effort driver-level erase first...
    WiFi.disconnect(false, true);   // ...keep WiFi up so the erase can actually run
    delay(100);
    nvs_handle_t h;                 // ...then the guaranteed path: wipe the driver's namespace
    if (nvs_open("nvs.net80211", NVS_READWRITE, &h) == ESP_OK) {
        nvs_erase_all(h);
        nvs_commit(h);
        nvs_close(h);
    }
    delay(300);                     // let NVS finish committing before the reboot
    ESP.restart();
}

static void handleBright() {
    if (refuseUnlessPageFetch()) return;
    if (g_web.hasArg("v")) {
        g_brightnessDay = constrain((int)g_web.arg("v").toInt(), 5, 255);  // floor 5: 0 looks like a dead board
        applyBrightness();
        if (g_web.hasArg("save")) {
            Preferences p;
            p.begin("capsuleradar", false);
            p.putInt("bright", g_brightnessDay);
            p.end();
        }
    }
    g_web.send(200, "text/plain", "ok");
}

static void handleVol() {
    if (refuseUnlessPageFetch()) return;
    if (g_web.hasArg("v"))    { g_volume = constrain((int)g_web.arg("v").toInt(), 0, 100); audio_set_volume(g_volume); }
    if (g_web.hasArg("mute")) { g_muted = g_web.arg("mute").toInt() != 0; audio_set_muted(g_muted); }
    if (g_web.hasArg("save")) {
        Preferences p;
        p.begin("capsuleradar", false);
        p.putInt("vol", g_volume);
        p.putBool("mute", g_muted);
        p.end();
    }
    if (g_web.hasArg("test")) {
        if (g_web.arg("test").toInt() == 2) audio_selftest();   // long tone, ignores mute
        else audio_play(AUDIO_NEW);
    }
    g_web.send(200, "text/plain", "ok");
}

static void handleAlerts() {   // what triggers the alert sound (live)
    if (refuseUnlessPageFetch()) return;
    if (g_web.hasArg("mode")) g_alertMode   = constrain((int)g_web.arg("mode").toInt(), 0, 2);
    if (g_web.hasArg("prox")) {
        g_proximityKm = g_web.arg("prox").toFloat();   // km (0 = off)
        g_requeryKm = queryRadiusKm();                 // the query must cover the new alert circle
        g_requery = true;
    }
    if (g_web.hasArg("save")) {
        Preferences p;
        p.begin("capsuleradar", false);
        p.putInt("alertmode", g_alertMode);
        p.putFloat("proxkm", g_proximityKm);
        p.end();
    }
    g_web.send(200, "text/plain", "ok");
}

static void handleIdle() {   // idle auto-dim timeout (seconds; 0 = never)
    if (refuseUnlessPageFetch()) return;
    if (g_web.hasArg("v")) {
        const long s = g_web.arg("v").toInt();
        g_idleDimMs = (s <= 0) ? 0 : (uint32_t)s * 1000;
        if (g_web.hasArg("save")) {
            Preferences p;
            p.begin("capsuleradar", false);
            p.putUInt("idledim", g_idleDimMs);
            p.end();
        }
    }
    g_web.send(200, "text/plain", "ok");
}

static void handleUnits() {   // measurement units preset (live re-render)
    if (refuseUnlessPageFetch()) return;
    if (g_web.hasArg("v")) {
        g_units = constrain((int)g_web.arg("v").toInt(), 0, 2);
        ui_set_units(g_units);
        ui_set_range_km(g_settings.rangeKm);   // refresh the zoom-button label
        ui_on_data_updated();                  // re-render card/list/stats in the new units
        if (g_web.hasArg("save")) {
            Preferences p;
            p.begin("capsuleradar", false);
            p.putInt("units", g_units);
            p.end();
        }
    }
    g_web.send(200, "text/plain", "ok");
}

static void handleSweep() {   // show/hide the rotating sweep line (live)
    if (refuseUnlessPageFetch()) return;
    if (g_web.hasArg("v")) {
        g_showSweep = g_web.arg("v").toInt() != 0;
        radar::setSweepEnabled(g_showSweep);          // loop()/core 1: safe to touch LVGL
        if (g_web.hasArg("save")) {
            Preferences p;
            p.begin("capsuleradar", false);
            p.putBool("sweep", g_showSweep);
            p.end();
        }
    }
    g_web.send(200, "text/plain", "ok");
}

static void handleClock() {   // idle clock on/off (live; off = the plain idle dim)
    if (refuseUnlessPageFetch()) return;
    if (g_web.hasArg("v")) {
        g_clockOn = g_web.arg("v").toInt() != 0;      // loop() starts or ends it on its next pass
        if (g_web.hasArg("save")) {
            Preferences p;
            p.begin("capsuleradar", false);
            p.putBool("clock", g_clockOn);
            p.end();
        }
    }
    g_web.send(200, "text/plain", "ok");
}

static void handleTrail() {   // aircraft trail length 0/1/2/3 (live)
    if (refuseUnlessPageFetch()) return;
    if (g_web.hasArg("v")) {
        g_trailLen = constrain((int)g_web.arg("v").toInt(), 0, 3);
        radar::setTrailLength(g_trailLen);
        if (g_web.hasArg("save")) {
            Preferences p;
            p.begin("capsuleradar", false);
            p.putInt("traillen", g_trailLen);
            p.end();
        }
    }
    g_web.send(200, "text/plain", "ok");
}

static void handleAltMin() {   // minimum-altitude feed filter, ft (applies from the next poll)
    if (refuseUnlessPageFetch()) return;
    if (g_web.hasArg("v")) {
        g_minAltFt = constrain((int)g_web.arg("v").toInt(), 0, 60000);
        g_adsb.setMinAltFt((float)g_minAltFt);
        if (g_web.hasArg("save")) {
            Preferences p;
            p.begin("capsuleradar", false);
            p.putInt("minalt", g_minAltFt);
            p.end();
        }
    }
    g_web.send(200, "text/plain", "ok");
}

static void handleAltMax() {   // maximum-altitude feed filter, ft (applies from the next poll)
    if (refuseUnlessPageFetch()) return;
    if (g_web.hasArg("v")) {
        g_maxAltFt = constrain((int)g_web.arg("v").toInt(), 0, 60000);
        g_adsb.setMaxAltFt((float)g_maxAltFt);
        if (g_web.hasArg("save")) {
            Preferences p;
            p.begin("capsuleradar", false);
            p.putInt("maxalt", g_maxAltFt);
            p.end();
        }
    }
    g_web.send(200, "text/plain", "ok");
}

static void handleMilOnly() {   // military-only feed filter (applies from the next poll)
    if (refuseUnlessPageFetch()) return;
    if (g_web.hasArg("v")) {
        g_milOnly = g_web.arg("v").toInt() != 0;
        g_adsb.setMilitaryOnly(g_milOnly);
        if (g_web.hasArg("save")) {
            Preferences p;
            p.begin("capsuleradar", false);
            p.putBool("milonly", g_milOnly);
            p.end();
        }
    }
    g_web.send(200, "text/plain", "ok");
}

static void handleBigText() {   // accessibility: large fonts. Fonts are baked at UI creation,
    if (refuseUnlessPageFetch()) return;
    if (g_web.hasArg("v")) {    // so persist the flag and reboot cleanly to apply it.
        g_bigText = g_web.arg("v").toInt() != 0;
        Preferences p;
        p.begin("capsuleradar", false);
        p.putBool("bigtext", g_bigText);
        p.end();
        g_rebootAtMs = millis() + 1200;   // let this response reach the browser first
    }
    g_web.send(200, "text/plain", "ok");
}

static void handleMaxAc() {   // max aircraft drawn on the scope (live)
    if (refuseUnlessPageFetch()) return;
    if (g_web.hasArg("v")) {
        g_maxAc = constrain((int)g_web.arg("v").toInt(), 1, ADSB_MAX_AIRCRAFT);
        radar::setMaxOnScreen(g_maxAc);
        if (g_web.hasArg("save")) {
            Preferences p;
            p.begin("capsuleradar", false);
            p.putInt("maxac", g_maxAc);
            p.end();
        }
    }
    g_web.send(200, "text/plain", "ok");
}

static void handleAirports() {   // show/hide airport markers (live)
    if (refuseUnlessPageFetch()) return;
    if (g_web.hasArg("v")) {
        g_showAirports = g_web.arg("v").toInt() != 0;
        radar::setAirportsEnabled(g_showAirports);
        if (g_web.hasArg("save")) {
            Preferences p;
            p.begin("capsuleradar", false);
            p.putBool("airports", g_showAirports);
            p.end();
        }
    }
    g_web.send(200, "text/plain", "ok");
}

static void handleFdSleep() {   // face-down sleep (screen off when flipped over) on/off
    if (refuseUnlessPageFetch()) return;
    if (g_web.hasArg("v")) {
        g_fdSleep = g_web.arg("v").toInt() != 0;
        if (g_web.hasArg("save")) {
            Preferences p;
            p.begin("capsuleradar", false);
            p.putBool("fdsleep", g_fdSleep);
            p.end();
        }
    }
    g_web.send(200, "text/plain", "OK");
}

static void handleGround() {   // hide/show on-ground aircraft (applies from the next feed poll)
    if (refuseUnlessPageFetch()) return;
    if (g_web.hasArg("v")) {
        g_hideGround = g_web.arg("v").toInt() != 0;
        g_adsb.setHideGround(g_hideGround);
        if (g_web.hasArg("save")) {
            Preferences p;
            p.begin("capsuleradar", false);
            p.putBool("hideground", g_hideGround);
            p.end();
        }
    }
    g_web.send(200, "text/plain", "ok");
}

static void handleRotate() {   // arbitrary clockwise display rotation, applied live
    if (refuseUnlessPageFetch()) return;
    if (g_web.hasArg("v")) {
        g_rotation = constrain((int)g_web.arg("v").toInt(), 0, 359);
        display::setRotation((uint16_t)g_rotation);
        g_rotation = display::rotation();
        if (g_web.hasArg("save")) {
            Preferences p;
            p.begin("capsuleradar", false);
            p.putInt("rotDeg", g_rotation);
            p.end();
        }
    }
    g_web.send(200, "text/plain", "ok");
}

static void handleGps() {   // auto-set the centre point from the LC76G GPS (-G variant)
    if (refuseUnlessPageFetch()) return;
    if (g_web.hasArg("v")) {
        g_useGps = g_web.arg("v").toInt() != 0;
        if (g_web.hasArg("save")) {
            Preferences p;
            p.begin("capsuleradar", false);
            p.putBool("usegps", g_useGps);
            p.end();
        }
    }
    g_web.send(200, "text/plain", "ok");
}

// ---- browser OTA: upload an app .bin over WiFi and self-flash ----
static void handleUpdatePage() {
    g_web.send(200, "text/html",
        "<!DOCTYPE html><html><head><meta charset=utf-8>"
        "<meta name=viewport content='width=device-width,initial-scale=1'>"
        "<title>Capsule Radar - Update</title><style>"
        "body{background:radial-gradient(circle at 50% -10%,#0a1f15,#04100a 70%);color:#cdd6d1;"
        "font-family:system-ui,sans-serif;margin:0 auto;padding:20px;max-width:480px;min-height:100vh}"
        "h1{color:#1dff86;font-size:20px}.card{background:rgba(10,20,14,.85);border:1px solid #1f3a2b;border-radius:14px;padding:16px}"
        "input,button{width:100%;box-sizing:border-box;padding:11px;border-radius:8px;margin-top:8px;font-size:16px}"
        "input{background:#0c1a12;color:#eafff3;border:1px solid #2a4a39}"
        "button{border:0;background:#1dff86;color:#04140b;font-weight:700}"
        "#bar{height:12px;background:#0c1a12;border-radius:6px;overflow:hidden;margin-top:14px;display:none}"
        "#fill{height:100%;width:0;background:#1dff86;transition:width .2s}#msg{margin-top:10px;color:#9affc8;font-size:13px}"
        "a{color:#1dff86}p{color:#9affc8;font-size:13px}"
        "</style></head><body><h1>Firmware update (OTA)</h1><div class=card>"
        "<p>Upload the <b>app firmware</b> <code>CapsuleRadar-ota.bin</code> from the GitHub release. "
        "Do NOT use the merged flash image here.</p>"
        "<input type=file id=f accept='.bin'>"
        "<button onclick=u()>Update over WiFi</button>"
        "<div id=bar><div id=fill></div></div><div id=msg></div></div>"
        "<p style='text-align:center;margin-top:14px'><a href=/>&larr; Back to settings</a></p>"
        "<script>function u(){var f=document.getElementById('f').files[0];if(!f){return}"
        "var x=new XMLHttpRequest(),fd=new FormData();fd.append('f',f);"
        "document.getElementById('bar').style.display='block';"
        "x.upload.onprogress=function(e){if(e.lengthComputable)document.getElementById('fill').style.width=(e.loaded/e.total*100)+'%'};"
        "x.onload=function(){var t=x.responseText;document.getElementById('msg').innerText=t=='OK'?t+' - rebooting...':t;};"
        "x.onerror=function(){document.getElementById('msg').innerText='Upload failed'};"
        "x.open('POST','/update');x.send(fd);}</script></body></html>");
}

static void handleUpdateUpload() {
    HTTPUpload &up = g_web.upload();
    if (up.status == UPLOAD_FILE_START) {
        g_updateDone = false;
        g_updateBlocked = requestCrossSite();   // can't answer from here: 403 goes out on completion
        if (g_updateBlocked) { Serial.println("[update] upload refused (cross-site)"); return; }
        Serial.printf("[update] start: %s\n", up.filename.c_str());
        // An earlier upload that never reached END (page closed, WiFi drop) leaves Update
        // "running"; begin() then fails and EVERY later upload bricks at 0 % until a
        // reboot. Abort any stale session first, then start clean.
        if (Update.isRunning()) Update.abort();
        if (!Update.begin(UPDATE_SIZE_UNKNOWN)) Update.printError(Serial);
    } else if (up.status == UPLOAD_FILE_WRITE) {
        if (!g_updateBlocked && Update.isRunning() &&
            Update.write(up.buf, up.currentSize) != up.currentSize) Update.printError(Serial);
    } else if (up.status == UPLOAD_FILE_END) {
        if (g_updateBlocked) return;           // refused above: nothing to finish
        g_updateDone = Update.end(true);
        if (g_updateDone) Serial.printf("[update] done: %u bytes\n", (unsigned)up.totalSize);
        else Update.printError(Serial);
    } else if (up.status == UPLOAD_FILE_ABORTED) {
        // The browser gave up mid-stream. Free the writer so the NEXT upload can begin.
        Update.abort();
        Serial.println("[update] upload aborted");
    }
}

#ifdef PIN_BOOT_BUTTON
// --- BOOT button deep sleep (config.h BOOT_BTN_*) ---------------------------------------
// A long press puts the radar into deep sleep; a press on the button wakes the chip, and
// bootWakeCheck() lets it start only if that press is held. GPIO0 is an RTC pin on the S3,
// so the RTC domain keeps the pull-up and the wake-on-low armed while everything else is off.
static void sleepUntilBootButton() {
    const gpio_num_t pin = (gpio_num_t)PIN_BOOT_BUTTON;
    rtc_gpio_init(pin);
    rtc_gpio_set_direction(pin, RTC_GPIO_MODE_INPUT_ONLY);
    rtc_gpio_pullup_en(pin);
    rtc_gpio_pulldown_dis(pin);
    esp_sleep_enable_ext0_wakeup(pin, 0);   // low = pressed
    Serial.flush();
    esp_deep_sleep_start();
}

// Long press, button let go: panel off, WiFi off, deep sleep. Called from loop() only once
// the button is up, or the level wake-up would fire at once.
static void bootButtonSleep() {
    Serial.println("[btn] deep sleep (hold the button to wake)");
    display::setBrightness(0);
    display::sleep();
    WiFi.disconnect(true);
    WiFi.mode(WIFI_OFF);
    sleepUntilBootButton();
}

// Woken by the BOOT button: carry on only if the press lasts BOOT_BTN_WAKE_HOLD_MS, so a bump
// in a bag doesn't switch the radar on. Runs first in setup(), before the panel lights up.
static void bootWakeCheck() {
    if (esp_sleep_get_wakeup_cause() != ESP_SLEEP_WAKEUP_EXT0) return;
    rtc_gpio_deinit((gpio_num_t)PIN_BOOT_BUTTON);
    pinMode(PIN_BOOT_BUTTON, INPUT_PULLUP);
    const uint32_t t0 = millis();
    uint32_t upSince = 0;
    while (millis() - t0 < BOOT_BTN_WAKE_HOLD_MS) {
        if (digitalRead(PIN_BOOT_BUTTON) == HIGH) {
            if (!upSince) upSince = millis();
            if (millis() - upSince >= BOOT_BTN_DEBOUNCE_MS) {
                Serial.println("[btn] short press while asleep: back to sleep");
                sleepUntilBootButton();
            }
        } else {
            upSince = 0;
        }
        delay(5);
    }
    Serial.println("[btn] woken by a long press");
}
#endif

void setup() {
    Serial.begin(115200);
    delay(200);
    Serial.println("\nCapsule Radar boot  fw " FW_VERSION "  board " BOARD_NAME);
#ifdef PIN_BOOT_BUTTON
    bootWakeCheck();                    // woken by the BOOT button: start only on a long press
    pinMode(PIN_BOOT_BUTTON, INPUT_PULLUP);
#endif

    if (PIN_LCD_SCLK < 0 || PIN_I2C_SDA < 0) {
        Serial.println("[!] Pins in config.h are still -1. Copy them from the Waveshare demo.");
    }
    Serial.printf("PSRAM: %u bytes free\n", (unsigned)ESP.getFreePsram());
    mbedtls_platform_set_calloc_free(tls_calloc, tls_free);   // before any TLS use

    loadSettings();
    route_cache_begin();   // clear stale route cache if the label format changed

    // --- Display + LVGL (M0) ----------------------------------------------
    // CO5300 AMOLED over QSPI + LVGL draw buffers in PSRAM, then a hello screen.
    // The panel is powered from the always-on DC1 rail, so it lights without the
    // PMIC. Touch (CST9217 indev) + AXP2101 come in later milestones.
    if (!display::begin()) {
        Serial.println("[!] display::begin() failed — check QSPI pins / power.");
    } else if (display::sweepAvailable()) {
        radar::setSweepCompositor(display::sweepConfig, display::sweepTick, display::sweepAngleDeg);   // per-pixel sweep (display.cpp)
    }

    // restore the saved theme, then persist any future change
    {
        Preferences p;
        p.begin("capsuleradar", true);
        const int t = p.getInt("theme", THEME_PHOSPHOR);
        g_showSweep = p.getBool("sweep", true);
        g_showAirports = p.getBool("airports", true);
        g_hideGround = p.getBool("hideground", false);
        g_minAltFt = p.getInt("minalt", 0);
        g_maxAltFt = p.getInt("maxalt", 0);
        g_lastView = p.getInt("lastview", 0);
        g_milOnly = p.getBool("milonly", false);
        // Migrate the old quarter-turn setting (rot=0..3) without changing existing
        // installations' orientation. New firmware stores actual degrees separately.
        g_rotation = p.isKey("rotDeg") ? p.getInt("rotDeg", 0) : p.getInt("rot", 0) * 90;
        g_rotation = constrain(g_rotation, 0, 359);
        p.end();
        radar::setTheme(t);
        radar::setSweepEnabled(g_showSweep);
        radar::setAirportsEnabled(g_showAirports);
        g_adsb.setHideGround(g_hideGround);
        g_adsb.setMinAltFt((float)g_minAltFt);
        g_adsb.setMaxAltFt((float)g_maxAltFt);
        g_adsb.setMilitaryOnly(g_milOnly);
        // restore the last active view (car installs power-cycle constantly) and keep
        // remembering it; NVS write only when the view actually changes.
        ui_show_view(g_lastView);
        ui_set_view_changed_cb([](int idx) {
            if (idx == g_lastView) return;
            g_lastView = idx;
            Preferences q;
            q.begin("capsuleradar", false);
            q.putInt("lastview", idx);
            q.end();
        });
        radar::setTrailLength(g_trailLen);
        radar::setMaxOnScreen(g_maxAc);
        display::setRotation((uint16_t)g_rotation);
        g_rotation = display::rotation();
    }
    radar::setThemeChangedCb(saveTheme);
    ui_set_range_cb(onRangeChange);              // on-screen zoom button
    ui_set_units(g_units);                       // apply saved unit preset
    ui_set_range_km(g_settings.rangeKm);         // show the loaded range
    // (power-off button: registered below, only when the PMIC actually answered)

    imu_begin();       // face-down sleep (no-op if the IMU isn't detected)
    g_pmicOk = battery_begin();   // AXP2101 (false if it did not answer)
#if BOARD_HAS_PMIC
    // Power-off drives the AXP2101, so offer the Stats button only when one answered
    // (a null callback keeps it hidden; the web /poweroff also answers 501 below).
    if (g_pmicOk)
        ui_set_poweroff_cb([]() { g_powerOffAtMs = millis() + 600; });   // let 'Powering off' render first
#endif
    gps_begin();       // LC76G GNSS (no-op if not the -G variant)
    gps_set_idle_hook(display::sweepTick);   // keep the sweep moving during GPS reads (it never touches I2C)
    battery_enable_codec_rail();   // power the ES8311 analog rail before audio init

    setenv("TZ", g_tz.c_str(), 1); tzset();   // SAVED zone (not the Spain default): right clock before NTP
    rtc_begin();
    rtc_seed_clock();                   // offline clock/date from the PCF85063
    // The system clock may be RTC-seeded (looks valid, might drift). Only a real SNTP
    // sync may write the RTC back — the callback flags each sync, the 5 s tick (core 1)
    // does the I2C write, at most hourly.
    sntp_set_time_sync_notification_cb([](struct timeval *tv) {
        g_rtcSyncPending = true;   // SNTP task context: flag only, no I2C here
    });
    if (audio_begin()) {                // ES8311 alert pings (no-op if codec absent)
        audio_set_volume(g_volume);
        audio_set_muted(g_muted);
    }

    // --- Radar UI ----------------------------------------------------------
    // radar::init() runs inside display::begin() (LVGL must be up first).

    // --- WiFi (captive portal, non-blocking) ------------------------------
    // First boot opens the "CapsuleRadar-Setup" AP to enter WiFi creds. Non-blocking
    // so the radar keeps animating while you configure WiFi from your phone.
    g_wm.setConfigPortalBlocking(false);
    g_wm.setTitle("Capsule Radar");
    // light phosphor-green theme for the captive portal (small CSS, injected into <head>)
    g_wm.setCustomHeadElement(
        "<style>"
        "body{background:#06100a;color:#cdd6d1;font-family:system-ui,sans-serif}"
        "h1,h2,h3{color:#1dff86}"
        "button,input[type=submit],.btn{background:#1dff86!important;color:#04140b!important;"
        "border:0!important;border-radius:8px!important;font-weight:700}"
        "input,select{background:#0c1a12!important;color:#eafff3!important;"
        "border:1px solid #2a4a39!important;border-radius:8px!important}"
        "a{color:#1dff86}.q{filter:hue-rotate(90deg)}"
        "</style>");
    // After the portal saves new credentials, reboot for a clean start: WiFiManager's
    // own port-80 server (and mDNS) don't cleanly hand over to our web server / STA
    // interface in non-blocking mode, so the config page is flaky until a fresh boot.
    g_wm.setSaveConfigCallback([]() {
        Serial.println("[wifi] new credentials saved -> rebooting for a clean web/mDNS start");
        g_rebootAtMs = millis() + 2500;   // let the portal deliver its 'saved' page first
    });
    if (g_wm.autoConnect("CapsuleRadar-Setup")) {
        Serial.println("[wifi] connected");
    } else {
        Serial.println("[wifi] config portal open - join 'CapsuleRadar-Setup' to set WiFi; UI stays live");
        g_bootedIntoPortal = true;   // saved WiFi may just not be up yet (car hotspot) -> loop() retries it
    }

    // --- OTA ---------------------------------------------------------------
    // ArduinoOTA is started from loop() once WiFi connects (see otaUp there).

    // --- ADS-B client + task ----------------------------------------------
    float queryKm = queryRadiusKm();
    g_adsb.begin(g_settings.homeLat, g_settings.homeLon, queryKm);
    wx_radar_begin();
    cloud_image_begin();
    g_ac_mutex = xSemaphoreCreateMutex();
    xTaskCreatePinnedToCore(adsb_task, "adsb", ADSB_TASK_STACK_BYTES, nullptr, 1, nullptr, 0);  // TLS needs a big stack

    // configuration web page (http://capsuleradar.local/)
    g_web.on("/", handleRoot);
    g_web.on("/save", HTTP_POST, handleSave);
    g_web.on("/wifi", HTTP_POST, handleWifi);
    g_web.on("/bright", handleBright);
    g_web.on("/vol", handleVol);
    g_web.on("/alerts", handleAlerts);
    g_web.on("/idle", handleIdle);
    g_web.on("/clock", handleClock);
    g_web.on("/fdsleep", handleFdSleep);
    g_web.on("/sweep", handleSweep);
    g_web.on("/airports", handleAirports);
    g_web.on("/ground", handleGround);
    g_web.on("/altmin", handleAltMin);
    g_web.on("/altmax", handleAltMax);
    g_web.on("/milonly", handleMilOnly);
    g_web.on("/trail", handleTrail);
    g_web.on("/maxac", handleMaxAc);
    g_web.on("/bigtext", handleBigText);
    g_web.on("/rotate", handleRotate);
    g_web.on("/poweroff", HTTP_POST, []() {
        if (refuseIfCrossSite()) return;
#if !BOARD_HAS_PMIC
        g_web.send(501, "text/plain", "power off not supported on this board");
#else
        // Registered the Stats button on the same condition (setup): driving the
        // AXP2101 shutdown is the ONLY power-off path this firmware has.
        if (!g_pmicOk) { g_web.send(501, "text/plain", "power off not supported: PMIC not detected"); return; }
        g_web.send(200, "text/plain", "powering off");
        g_powerOffAtMs = millis() + 800;
#endif
    });
    g_web.on("/gps", handleGps);
    g_web.on("/units", handleUnits);
    g_web.on("/update", HTTP_GET, handleUpdatePage);
    g_web.on("/update", HTTP_POST,
        []() {
            // Check the request itself too: a POST with no file part never reaches the
            // upload handler, and used to answer "OK" and reboot the device.
            const bool refused = g_updateBlocked || requestCrossSite();
            const bool ok = !refused && g_updateDone;
            g_updateBlocked = g_updateDone = false;
            if (refused) { g_web.send(403, "text/plain", "cross-site request rejected"); return; }
            g_web.send(200, "text/plain", ok ? "OK" : "FAIL");
            delay(800);
            if (ok) ESP.restart();
        },
        handleUpdateUpload);
    // The CSRF guards read Sec-Fetch-Site / Origin / X-Radar; make the server collect them.
    static const char *WEB_GUARD_HDRS[] = {"Sec-Fetch-Site", "Origin", WEB_PAGE_HDR};
    g_web.collectHeaders(WEB_GUARD_HDRS, sizeof(WEB_GUARD_HDRS) / sizeof(WEB_GUARD_HDRS[0]));
    g_web.begin();

    applyBrightness();   // display::begin() opens at BRIGHTNESS_DEFAULT; honour the saved value

    Serial.println("setup done");
}

void loop() {
    display::loop();                // drive LVGL (render dirty areas + run timers)
    g_wm.process();                 // service the WiFi config portal (non-blocking)
    g_web.handleClient();           // serve the configuration web page
    if (g_useGps) gps_poll();       // pull NMEA from the LC76G (only when GPS auto-location is on)

    // scheduled reboot after a fresh WiFi config (see setSaveConfigCallback)
    if (g_rebootAtMs && (int32_t)(millis() - g_rebootAtMs) >= 0) { delay(50); ESP.restart(); }
    if (g_powerOffAtMs && (int32_t)(millis() - g_powerOffAtMs) >= 0) {
        g_powerOffAtMs = 0;
        // The button lives on the Stats view, so the remembered view would bring the radar
        // back up on Stats every time. A deliberate power-off starts again on the radar.
        if (g_lastView != 0) {
            g_lastView = 0;
            Preferences q;
            q.begin("capsuleradar", false);
            q.putInt("lastview", 0);
            q.end();
        }
        battery_power_off();
    }

    // Car use: the saved WiFi often appears 30-60 s AFTER boot (vehicle hotspot). If we booted
    // into the portal despite having saved credentials, keep retrying them in the background;
    // once the network shows up, reboot for a clean start (same rationale as the post-config
    // reboot: WiFiManager's portal server doesn't hand port 80 / mDNS over cleanly).
    if (g_bootedIntoPortal && !g_rebootAtMs) {
        static uint32_t lastRetry = 0;
        if (WiFi.status() == WL_CONNECTED) {
            Serial.println("[wifi] saved network appeared -> restarting for a clean start");
            g_rebootAtMs = millis() + 800;
        } else if (millis() - lastRetry > 20000UL && g_wm.getWiFiIsSaved()) {
            lastRetry = millis();
            Serial.println("[wifi] retrying saved network in the background...");
            WiFi.begin();                     // uses the stored credentials
        }
    }

    // OTA: set up once WiFi is up, then service it every loop (flash over the air)
    static bool otaUp = false;
    if (!otaUp && WiFi.status() == WL_CONNECTED) {
        ArduinoOTA.setHostname("capsuleradar");        // -> capsuleradar.local (registers mDNS)
        ArduinoOTA.begin();
        MDNS.addService("http", "tcp", 80);            // advertise the config web page
        otaUp = true;
        Serial.println("[ota] ready: pio run -e " BOARD_PIO_ENV "-ota -t upload");
    }
    if (otaUp) ArduinoOTA.handle();

    // Push a fresh ADS-B snapshot to the radar (copy under the mutex, render outside).
    if (g_acDirty) {
        if (xSemaphoreTake(g_ac_mutex, pdMS_TO_TICKS(5)) == pdTRUE) {
            g_snap.swap(g_aircraft);   // O(1) handoff under the lock; render on g_snap outside it.
            g_acDirty = false;         // g_aircraft now holds the previous snapshot (overwritten next poll)
            xSemaphoreGive(g_ac_mutex);
            radar::update(g_snap, g_settings); // rebuild the glyph/trail layer
            ui_on_data_updated();              // refresh card/list/stats
            checkAudioEvents();                // ping new-in-range / emergency / military
        }
    }
    if (g_weatherDirty) {
        g_weatherDirty = false;
        ui_on_data_updated();
    }
    if (g_wxRadarDirty) {
        g_wxRadarDirty = false;
        ui_on_data_updated();
    }
    if (g_cloudImageDirty) {
        g_cloudImageDirty = false;
        ui_on_data_updated();
    }

    // periodic: HUD clock + wifi/battery indicators
    static uint32_t lastStatus = 0;
    if (millis() - lastStatus > 5000) {
        lastStatus = millis();
#if DEBUG_MEM
        static uint32_t lastFrames = 0;
        const uint32_t fr = display_frames();
        const unsigned fps = (fr - lastFrames) / 5;
        lastFrames = fr;
        Serial.printf("[mem] heap %u (min %u, biggest %u) | psram %u free | up %lus | aircraft %d | fps %u\n",
                      (unsigned)ESP.getFreeHeap(), (unsigned)ESP.getMinFreeHeap(),
                      (unsigned)heap_caps_get_largest_free_block(MALLOC_CAP_INTERNAL),
                      (unsigned)ESP.getFreePsram(), (unsigned long)(millis() / 1000),
                      (int)g_snap.size(), fps);
#endif
        char clk[8] = "--:--";
        struct tm ti;
        const bool haveTime = getLocalTime(&ti, 0);
        if (haveTime) {
            snprintf(clk, sizeof(clk), "%02d:%02d", ti.tm_hour, ti.tm_min);
            char date[20];
            strftime(date, sizeof(date), "%d %b %Y", &ti);   // e.g. "08 Jun 2026"
            ui_set_date(date);
        }
        const bool wifiUp = (WiFi.status() == WL_CONNECTED);
        const int  rssi   = wifiUp ? (int)WiFi.RSSI() : -127;
        // "fresh" = we got aircraft data recently. Catches a stalled feed (weak WiFi dropping
        // polls intermittently) that never trips the consecutive-fail counter -> aircraft
        // freeze but the icon would otherwise stay white.
        const bool feedFresh = wifiUp && (millis() - g_lastFeedOkMs < 18000UL);
        ui_set_status(wifiUp, feedFresh, rssi, clk);
        char net[112];
        if (WiFi.status() == WL_CONNECTED)
            // IP + the active centre point (helps users verify what actually got saved)
            snprintf(net, sizeof(net), "Configure at\ncapsuleradar.local\n%s  |  %.5f, %.5f",
                     WiFi.localIP().toString().c_str(), g_settings.homeLat, g_settings.homeLon);
        else
            snprintf(net, sizeof(net), "WiFi setup:\njoin CapsuleRadar-Setup");
        ui_set_netinfo(net);
        ui_set_feed_source(g_adsb.lastHost());   // Stats "Feed" line: who served the last data
        const bool bpresent = battery_present();
        ui_set_battery(battery_percent(), battery_charging(), bpresent);
        // "On battery" must mean USB is absent, not "not charging": isCharging() goes
        // false once the battery is FULL, which used to slow polling to 5 s on a
        // USB-tethered, fully charged device.
        g_onBattery = bpresent && !battery_vbus_in();
        // GPS HUD/Stats: 0 = off/no module (hidden), 1 = acquiring, 2 = fix
        const int gpsState = (!g_useGps || !gps_present()) ? 0 : (gps_has_fix() ? 2 : 1);
        ui_set_gps(gpsState, gps_satellites(), gps_altitude_m());
        // Write the RTC only after a REAL SNTP sync (flagged by the callback in setup),
        // and at most hourly — the boot clock is RTC-seeded and looks valid too, which
        // used to let the 5 s tick write drift right back over a good time source.
        static uint32_t lastRtcWriteMs = 0;
        if (g_rtcSyncPending &&
            (lastRtcWriteMs == 0 || millis() - lastRtcWriteMs >= 3600000UL)) {
            time_t now = time(nullptr);
            struct tm utc;
            gmtime_r(&now, &utc);
            if (now > 1700000000L && rtc_write(&utc)) {   // sanity: a synced clock is past 2023
                g_rtcSyncPending = false;                 // cleared only on success: retry on I2C error
                lastRtcWriteMs = millis();
                Serial.println("[rtc] saved NTP time");
            }
        }
        // GPS auto-location (-G variant): re-centre the radar when the fix moves enough.
        if (g_useGps) {
            double glat, glon;
            if (gps_location(&glat, &glon) &&
                geo::haversineKm(g_settings.homeLat, g_settings.homeLon, glat, glon) > 1.0) {
                g_settings.homeLat = glat; g_settings.homeLon = glon;   // radar/coastline recenter
                // re-query the new area — set the radius too (same formula as boot/zoom), or
                // adsb_task would re-begin with a stale/zero g_requeryKm and fetch 0 aircraft.
                g_requeryKm = queryRadiusKm();
                g_requery = true;                                       // adsb_task re-queries the new area
                Serial.printf("[gps] re-centred to %.4f, %.4f\n", glat, glon);
            }
        }
    }

    // face-down -> screen off (IMU); flip face-up or touch to wake (see facedown_sleep.h)
    static uint32_t lastImu = 0;
    static FaceDownSleep faceDown;
    const uint32_t nowImu = millis();
    if (nowImu - lastImu > FACEDOWN_CHECK_MS) {
        const bool touched = touchedSinceLastCheck(display::inactiveMs(), nowImu - lastImu);
        lastImu = nowImu;
        int16_t az = 0;
        const bool haveAz = imu_read_az(&az);
        faceDown.update(haveAz, az, touched, g_fdSleep);   // g_fdSleep: web toggle
        g_asleep = faceDown.asleep();   // applyBrightness() below: dark (0) also makes a touch only wake it
    }

    // Idle: the clock, or the plain dim. Checked on every pass, so the touch that wakes the
    // radar sends the clock away at once. The clock needs the radar view on screen and a
    // known time (radar::setClock refuses without one, and is asked again next pass).
    g_idle = g_idleDimMs > 0 && display::inactiveMs() > g_idleDimMs;
    const bool wantClock = g_clockOn && g_idle && ui_sweep_visible();
    g_clockHold = wantClock && radar::emergencyInRange();      // an emergency nearby: radar stays up
    const bool showClock = wantClock && !g_clockHold;
    if (showClock != radar::clockRequested() && radar::setClock(showClock))
        Serial.println(showClock ? "[clock] idle: radar -> clock" : "[clock] radar is back");

#ifdef PIN_BOOT_BUTTON
    // BOOT button (the crown on a radar case): short press = next zoom step, long press = deep
    // sleep once it is let go (see config.h BOOT_BTN_*). A press on a dark or idle screen only
    // wakes it. The hold that woke the radar from deep sleep is ignored (BootButton unarmed).
    {
        static BootButton bootBtn(esp_sleep_get_wakeup_cause() != ESP_SLEEP_WAKEUP_EXT0);
        static bool wakeOnly = false;
        static bool sleepPending = false;
        const uint32_t nowBtn = millis();
        switch (bootBtn.update(digitalRead(PIN_BOOT_BUTTON) == LOW, nowBtn)) {
        case BootButton::PRESS:
            wakeOnly = g_asleep || g_idle;
            display::wake();               // light the screen: the hold ring has to be seen
            break;
        case BootButton::SHORT_PRESS:
            if (!wakeOnly) ui_cycle_range();
            break;
        case BootButton::LONG_PRESS:
            sleepPending = true;
            Serial.println("[btn] long press: release to sleep");
            break;
        default:
            break;
        }
        ui_button_hold(bootBtn.holdProgress(nowBtn), sleepPending);
        if (sleepPending && !bootBtn.down()) bootButtonSleep();
    }
#endif
    applyBrightness();

    delay(5);
}
