BaQs/dragon-radar/(commit log)

2026-11-02 Bouton BOOT : zoom à l'appui court, veille profonde à l'appui long
    Le bouton BOOT (GPIO0), actionné par la molette du boîtier Dragon Radar, devient
    la commande physique du radar :
    - appui court : pas de zoom suivant, comme le bouton tactile (sur un écran éteint
    ou en veille, l'appui le réveille seulement) ;
    - appui long (2 s) : l'anneau du bord d'écran se remplit, puis au relâchement
    l'écran et le WiFi se coupent et la carte passe en veille profonde ;
    - réveil : un appui réveille la puce, mais le radar ne démarre que si l'appui
    dure 1,5 s (un choc le renvoie en veille).
    Logique pure dans boot_button.h, testée sur l'hôte (tests/boot_button_test.cpp).
    Réglages BOOT_BTN_*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
2026-11-02 Dragon Radar : boîtier 3D pour la 1.43, README du projet
    - hardware/dragon-radar-1.43 : projet Bambu Studio (un plateau), STL et STEP de chaque pièce
    (face, dos, logo, molette, berceau, support), rendus, coupes, cotes ;
    - tools/dragon-radar : scripts de génération et de contrôle du boîtier ;
    - README du projet (matériel, impression, montage, firmware, mise à jour OTA) ; le README
    d'origine de Capsule Radar est conservé dans docs/CAPSULE_RADAR.md.
    [berceau.step, berceau.stl, dos.step, dos.stl, dragon-radar-1.43.3mf, face.step, face.stl, logo.step]
2026-11-02 Thème : un appui lent sur un avion ne change plus le thème
    L'appui long de LVGL (0,4 s) faisait défiler le thème au relâchement : un appui un peu lent
    pour inspecter un avion passait d'Orb au thème suivant, et après trois appuis on retombait
    sur Phosphor. L'appui était aussi perdu (la fiche de l'avion ne s'ouvrait pas).
    Le thème ne change plus qu'après un appui immobile de THEME_HOLD_MS (1,5 s) commencé hors de
    tout avion ; un appui plus court reste un appui normal. Version 1.6.0-dragon.2.
2026-11-02 Crédits : la base du projet est socquique/capsule-radar
    Retire le lien vers le modèle MakerWorld des crédits, des notices, des scripts et de la
    description du 3MF ; le projet renvoie à socquique/capsule-radar.
    [dragon-radar-1.43.3mf]
2026-11-02 Batterie : indicateur de niveau sur la 1.43
    La 1.43 n'a pas de PMIC : la tension du rail VCC est lue sur GPIO4 à travers un pont
    diviseur x3 (R11 200k / R13 100k sur le schéma Waveshare, même facteur que sa démo
    01_ADC_Test) et convertie en niveau par une courbe LiPo (battery_curve.h, testée sur
    l'hôte). Sur USB, VCC est le 5 V : l'indicateur montre le symbole de charge et le dernier
    niveau mesuré sur batterie. Sur batterie, le radar interroge le flux moins souvent, comme
    la 1.75. Version 1.6.0-dragon.3.
2026-11-02 Vue 3D interactive (GitHub Pages)
    docs/viewer : page three.js du radar monté, éclaté et en coupe, avec la carte 1.43, la
    batterie, le logo et la molette qui s'enfonce (appui court = zoom, appui long = veille).
    Le modèle est chargé depuis radar.mesh. docs/.nojekyll pour servir les fichiers tels quels.
2026-11-02 Pages : la racine du site renvoie vers la vue 3D
2026-11-02 make_3mf : noms des pièces en anglais (DRAGON_3MF_LANG=en) pour MakerWorld
2026-11-02 Lien vers la page MakerWorld (README, notice, vue 3D)
